Heinvdm/pebble/brain/tests/data/mouths/still/00.jpg

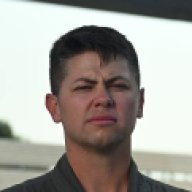
brain/tests/data/mouths/still/00.jpg
