Heinvdm/pebble/brain/tests/data/hazards/woodstove.jpg

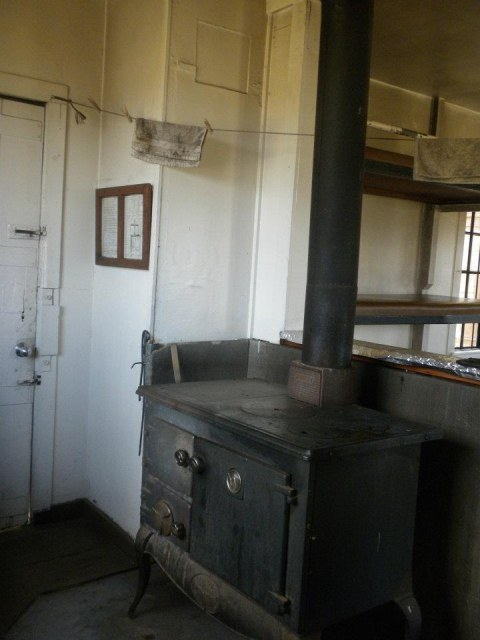
brain/tests/data/hazards/woodstove.jpg
