Heinvdm/pebble/reports/Hexapod motors and boards.md

# Low-resistance motors let Pebble's hexapod hop

Pebble's 12-motor hexapod can reach its hop target, but only with joints about twice the planned weight. The best fit for each lift joint is a **CubeMars GL30 gimbal motor (Ø34.5 × 15.7 mm, 41 g, 1.53 Ω)** turning a **single-stage printed planetary gear of about 8:1**, read by a **14-bit MT6701 magnetic encoder**, with an open **SimpleFOC-microspora-style board (STM32G431 + TI DRV8316, 33 × 34 mm, MIT licence)** bolted behind every motor. At the fixed 9 V the Xiaomi bank gives, a motor's winding resistance, not its size, decides whether it can push 0.35 Nm at 10 rad/s. The GL30 can, losing about 0.35 W per joint while holding the walking load. The cheaper, high-resistance **iPower GBM2804H-100T** reaches only about 0.17 Nm at hop speed, so it is better kept for the six swing joints,
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
