Heinvdm/pebble/android/docs/emulator-face.png

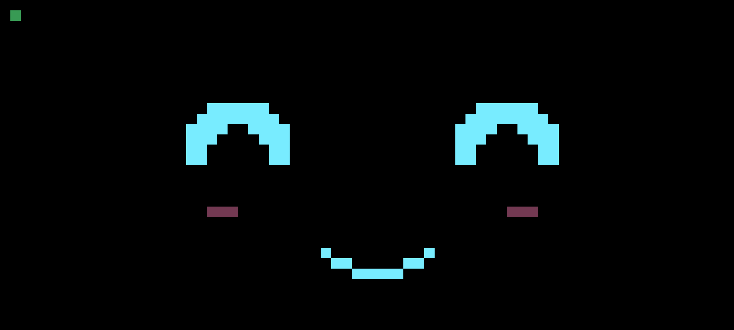
android/docs/emulator-face.png
