Heinvdm/pebble/cad/renders/detail_air_pod.png

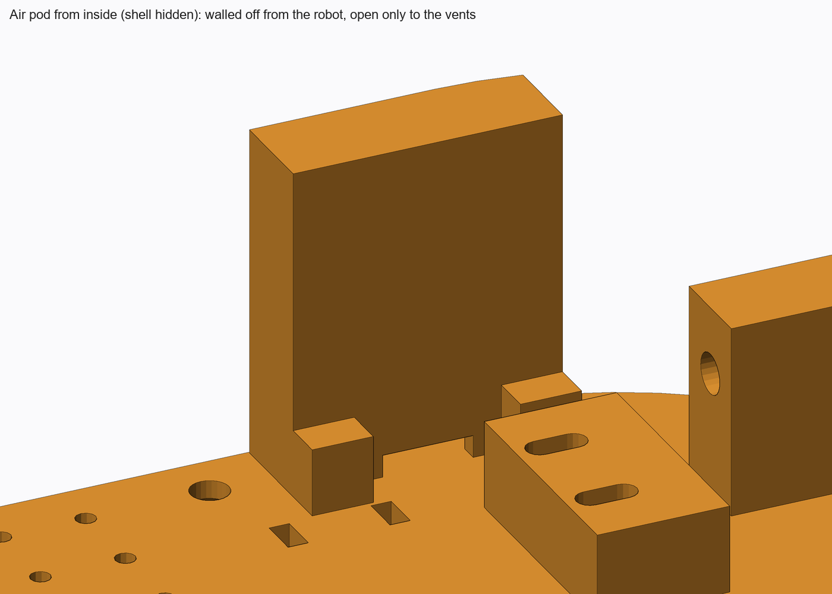
cad/renders/detail_air_pod.png
