Heinvdm/pebble/cad/renders/detail_air_vents.png

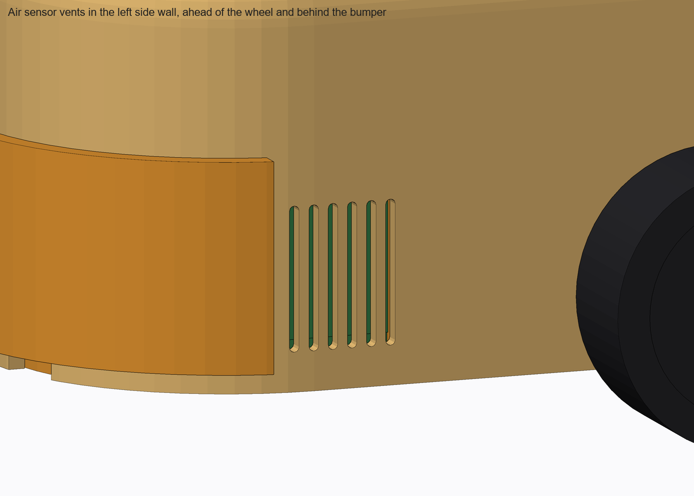
cad/renders/detail_air_vents.png
