Heinvdm/pebble/cad/renders/detail_front_interior.png

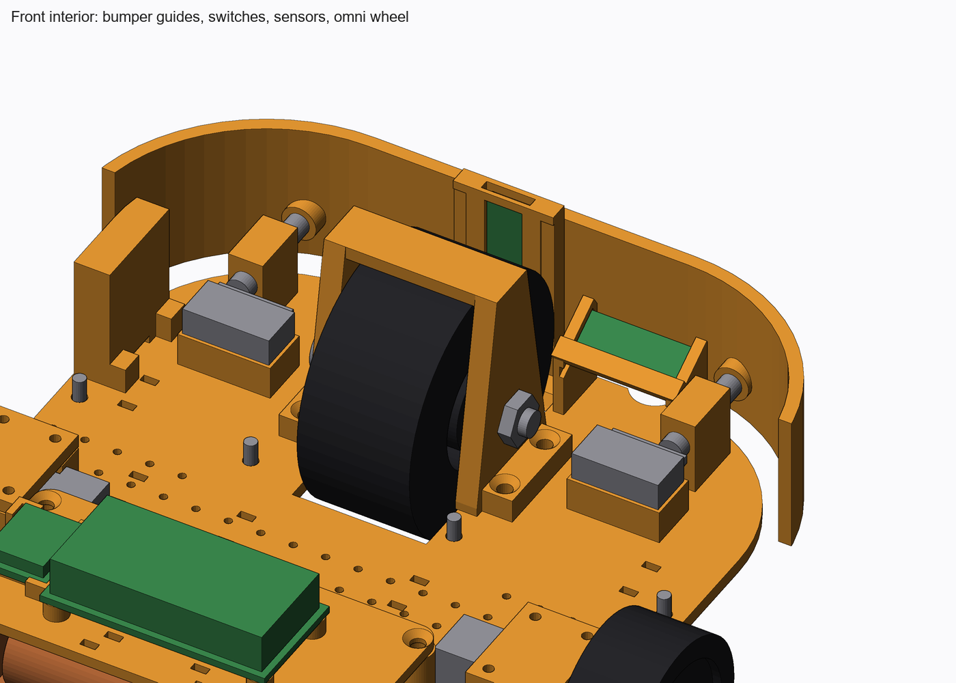
cad/renders/detail_front_interior.png
