Heinvdm/pebble/cad/renders/detail_neck_back.png

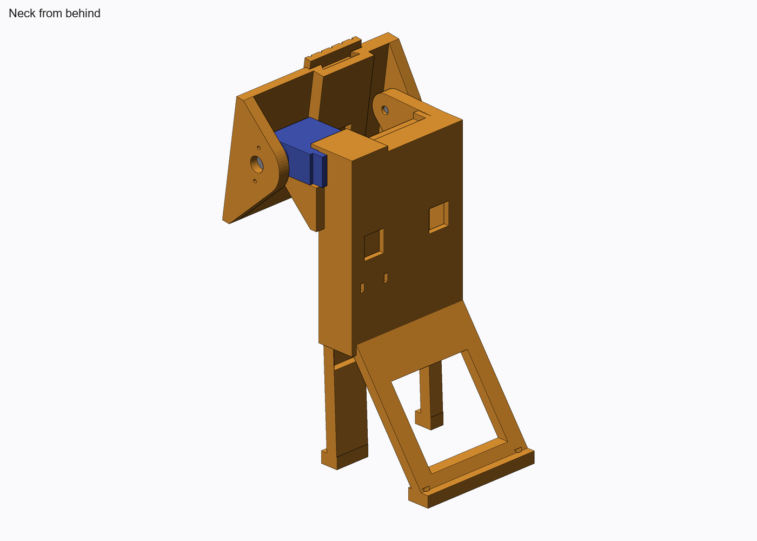
cad/renders/detail_neck_back.png
