Heinvdm/pebble/cad/renders/detail_neck_front.png

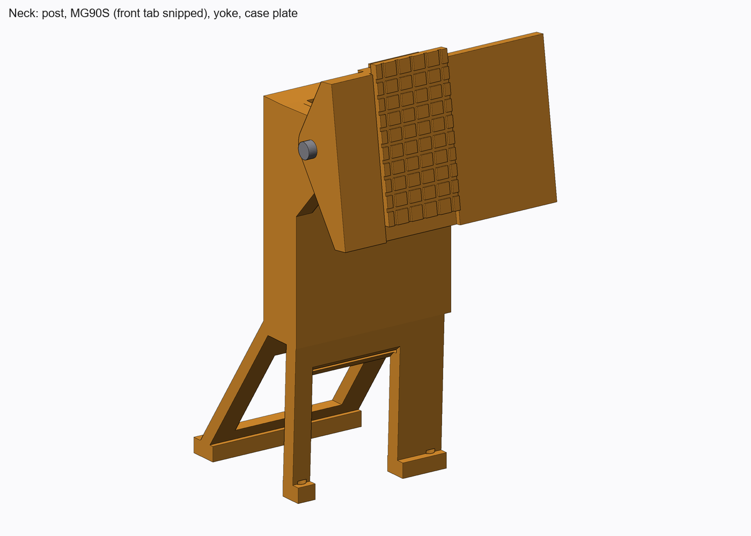
cad/renders/detail_neck_front.png
