Heinvdm/pebble/cad/renders/detail_rear_wall.png

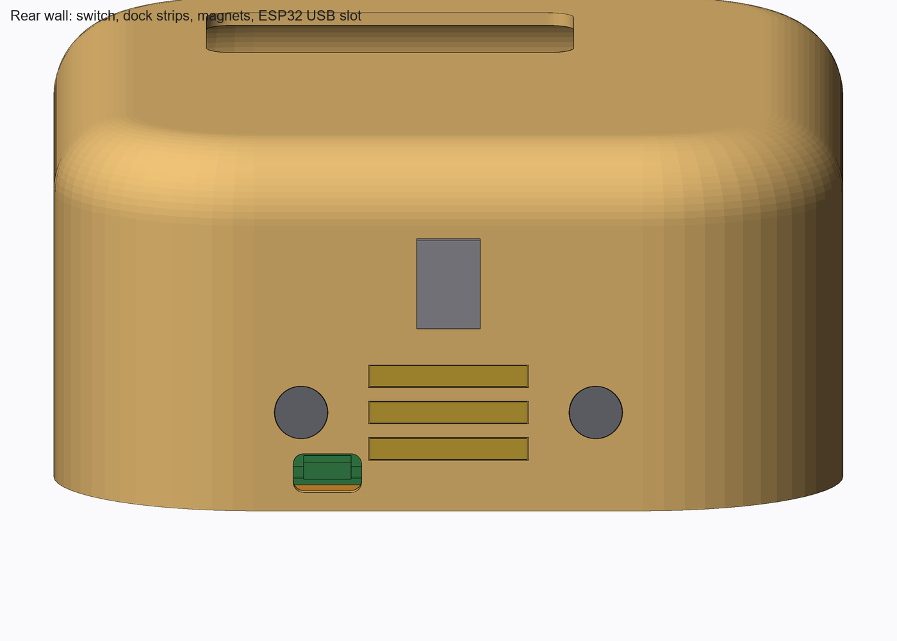
cad/renders/detail_rear_wall.png
