Heinvdm/pebble/cad/renders/detail_underside.png

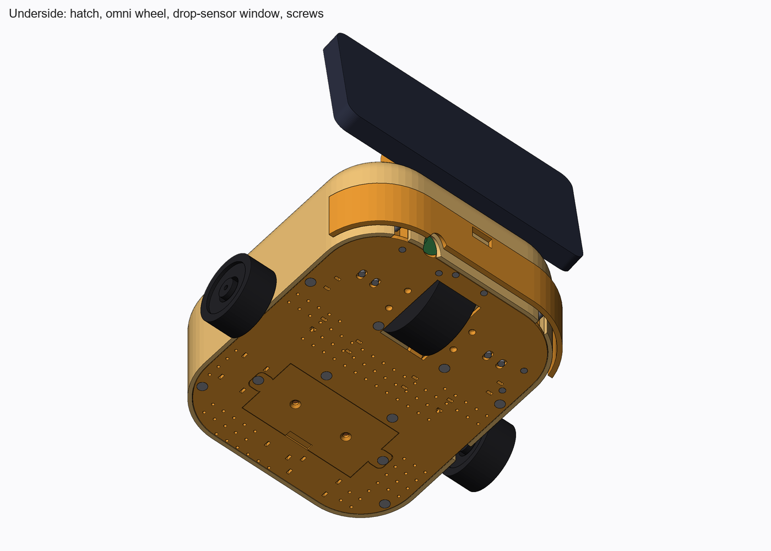
cad/renders/detail_underside.png
