Heinvdm/pebble/cad/renders/dock_iso.png

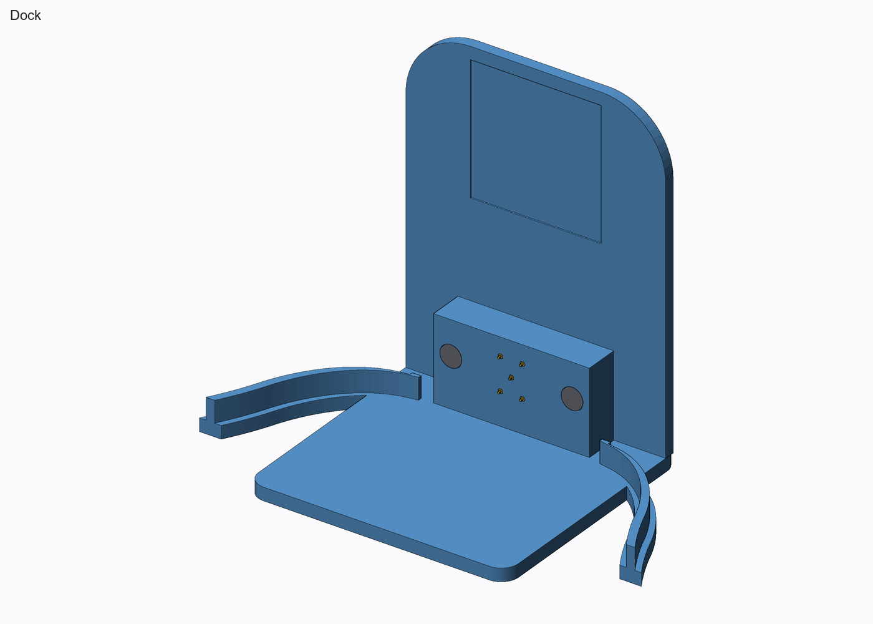
cad/renders/dock_iso.png
