Heinvdm/pebble/cad/renders/docked_rear_iso.png

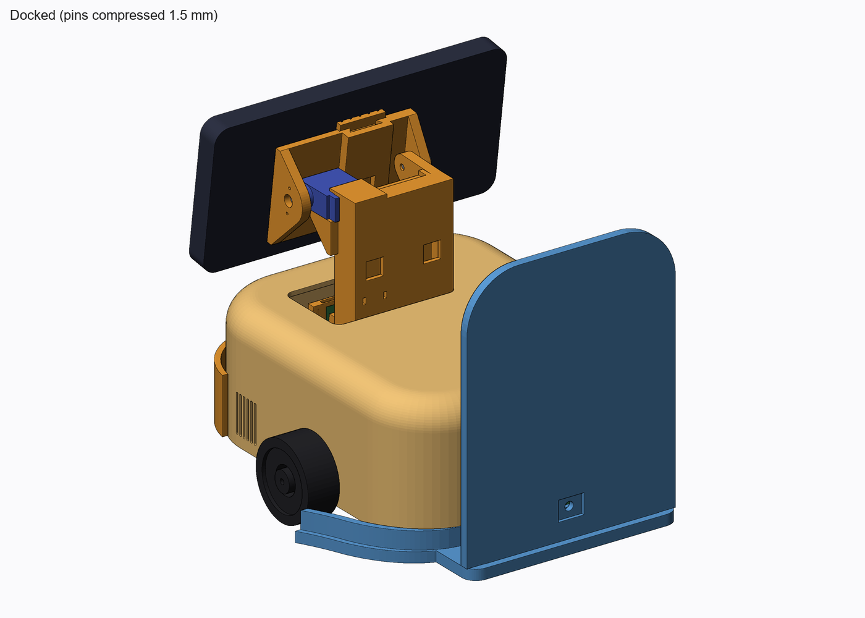
cad/renders/docked_rear_iso.png
