Heinvdm/pebble/cad/renders/docked_side.png

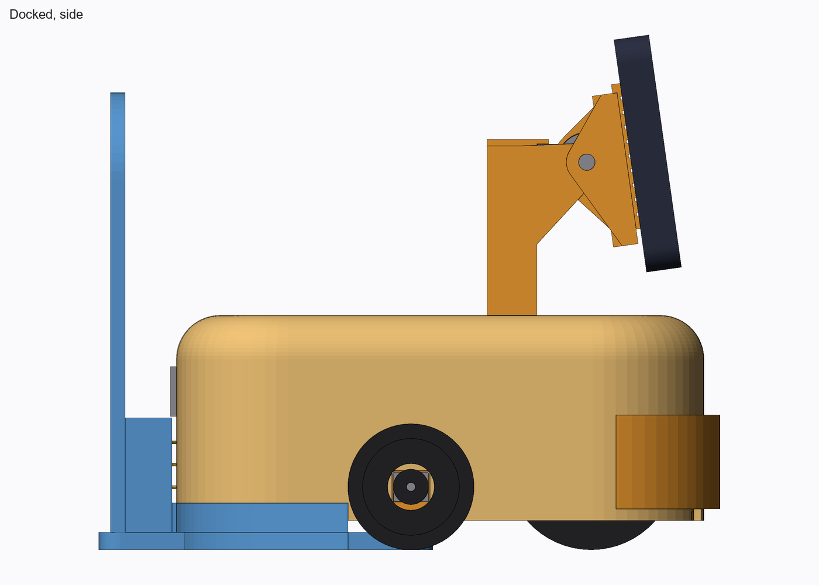
cad/renders/docked_side.png
