Heinvdm/pebble/cad/renders/drop_sensor_front_below.png

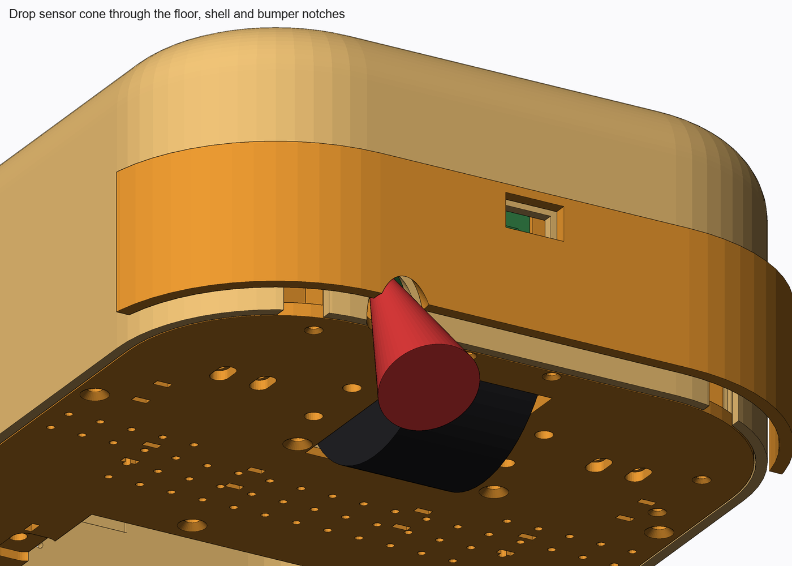
cad/renders/drop_sensor_front_below.png
