Heinvdm/pebble/cad/renders/drop_sensor_side.png

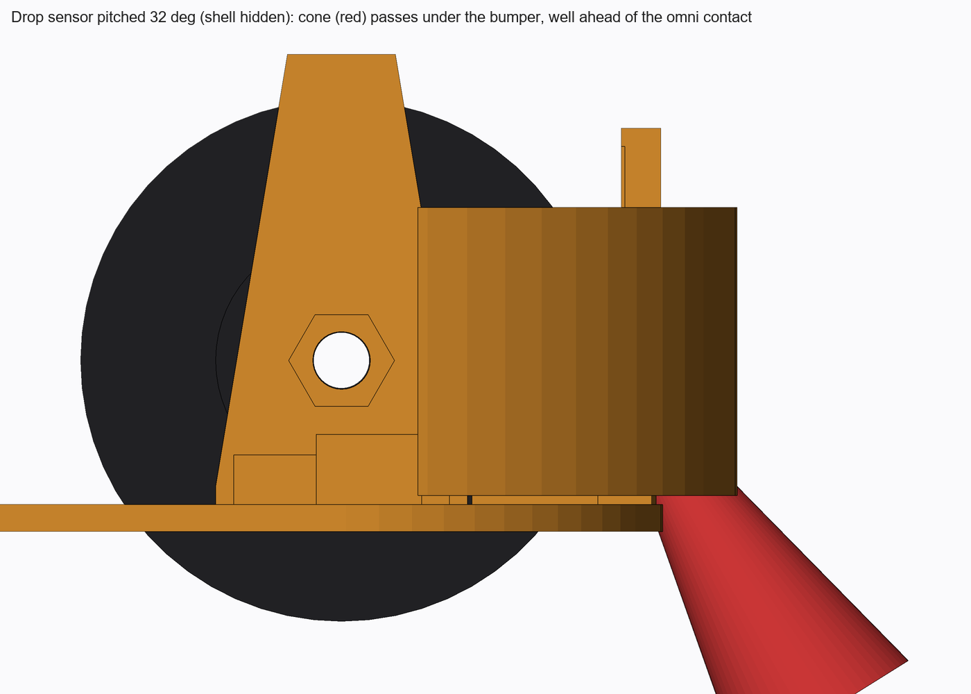
cad/renders/drop_sensor_side.png
