Heinvdm/pebble/cad/renders/layout_iso.png

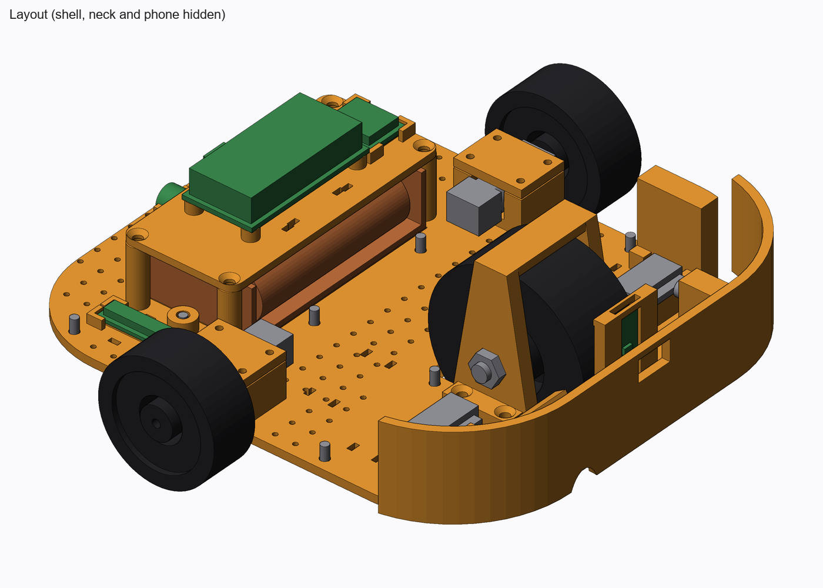
cad/renders/layout_iso.png
