Heinvdm/pebble/cad/renders/layout_top.png

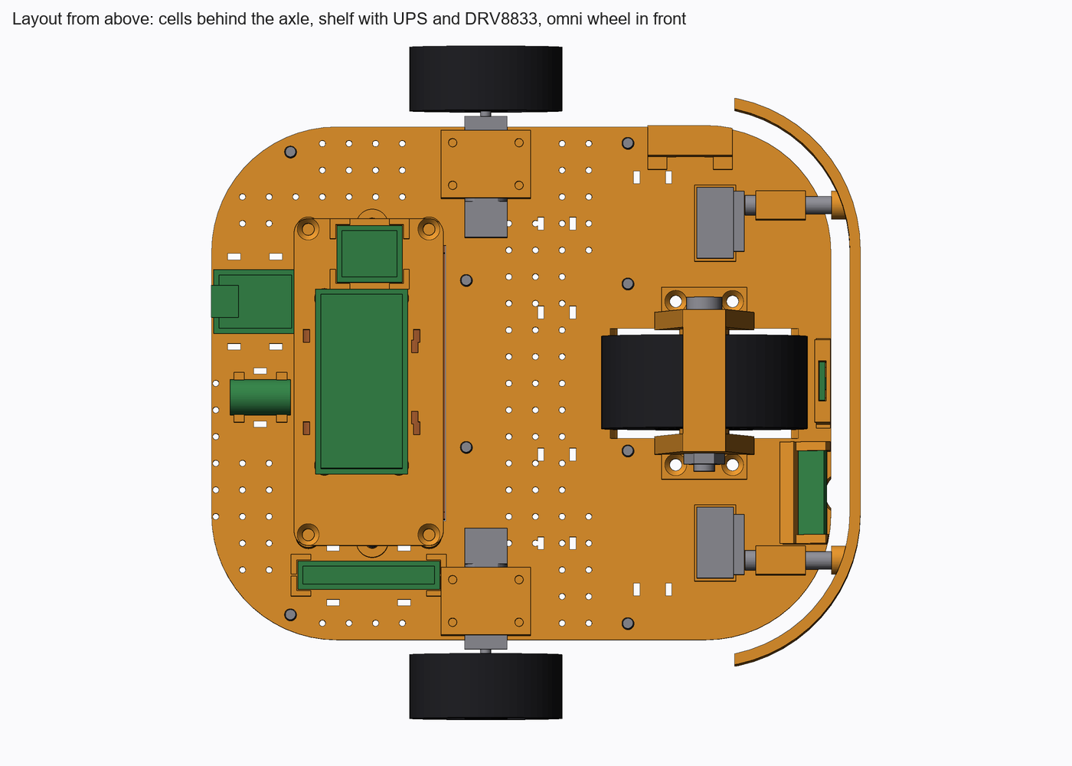
cad/renders/layout_top.png
