Heinvdm/pebble/cad/renders/omni_from_below.png

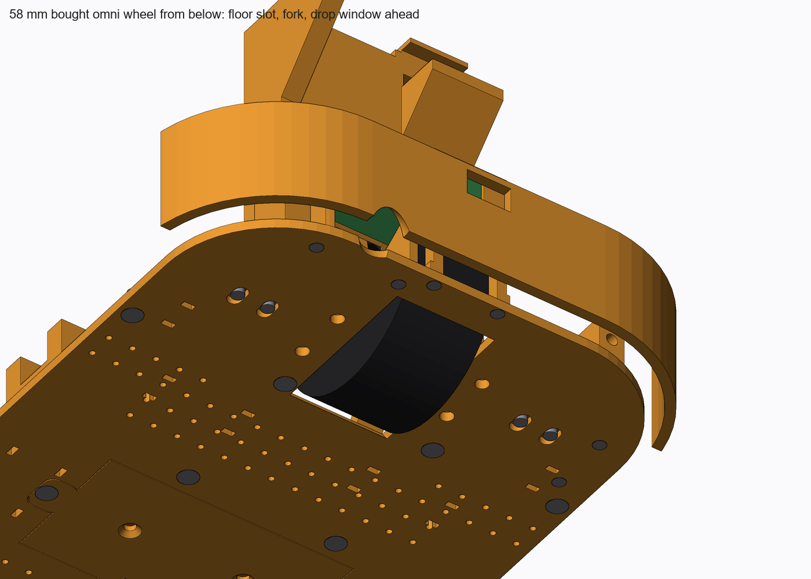
cad/renders/omni_from_below.png
