Heinvdm/pebble/cad/renders/omni_side.png

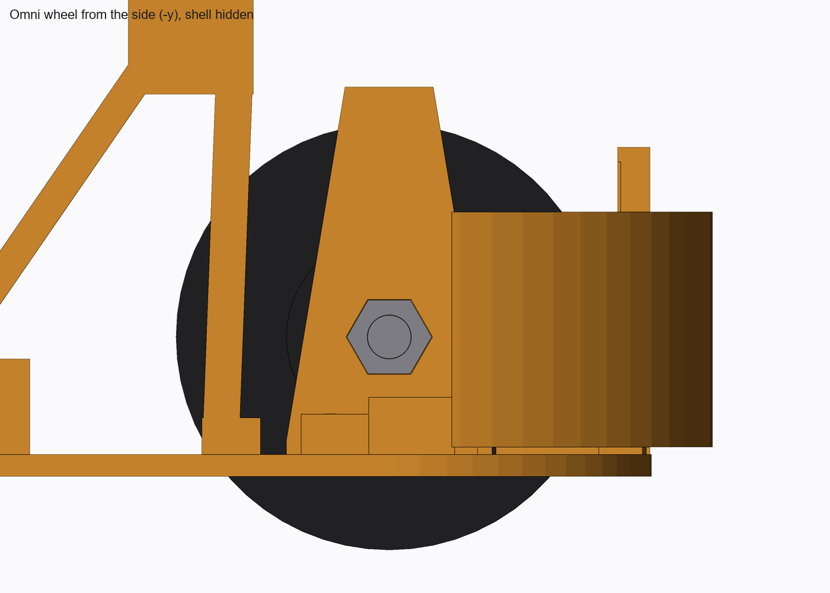
cad/renders/omni_side.png
