Heinvdm/pebble/cad/renders/part_air_pod.png

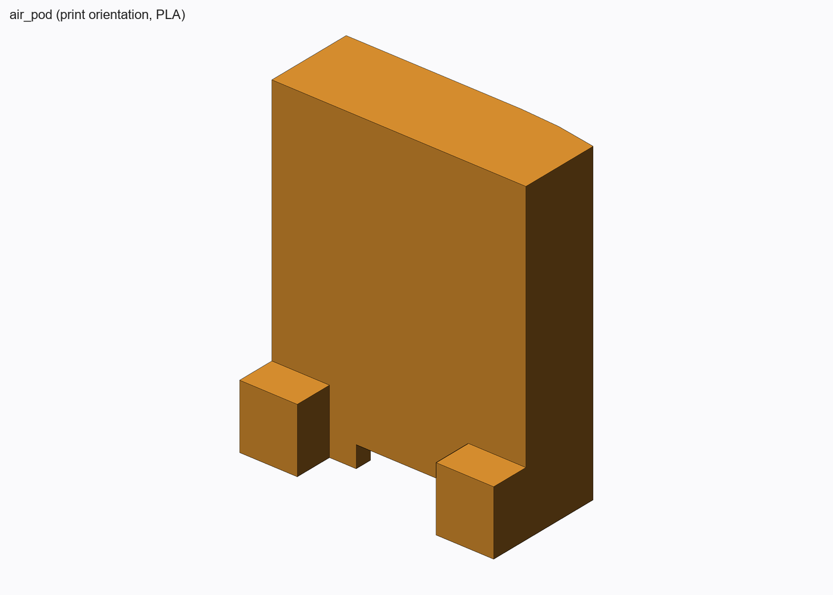
cad/renders/part_air_pod.png
