Heinvdm/pebble/cad/renders/part_battery_hatch.png

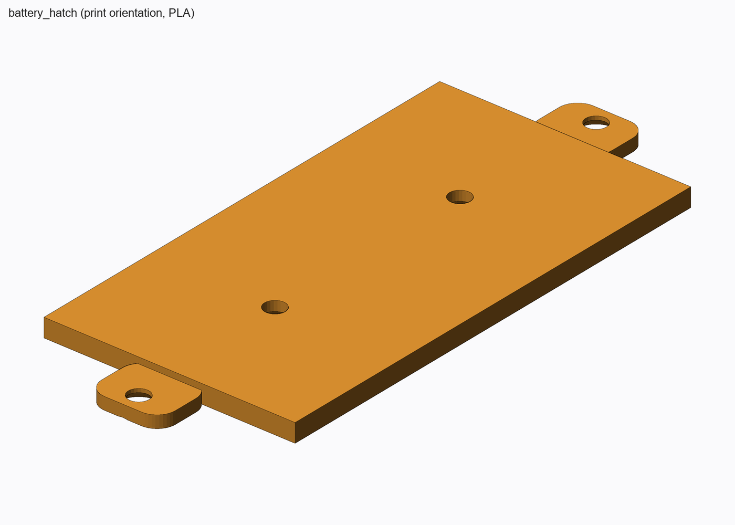
cad/renders/part_battery_hatch.png
