Heinvdm/pebble/cad/renders/part_bumper.png

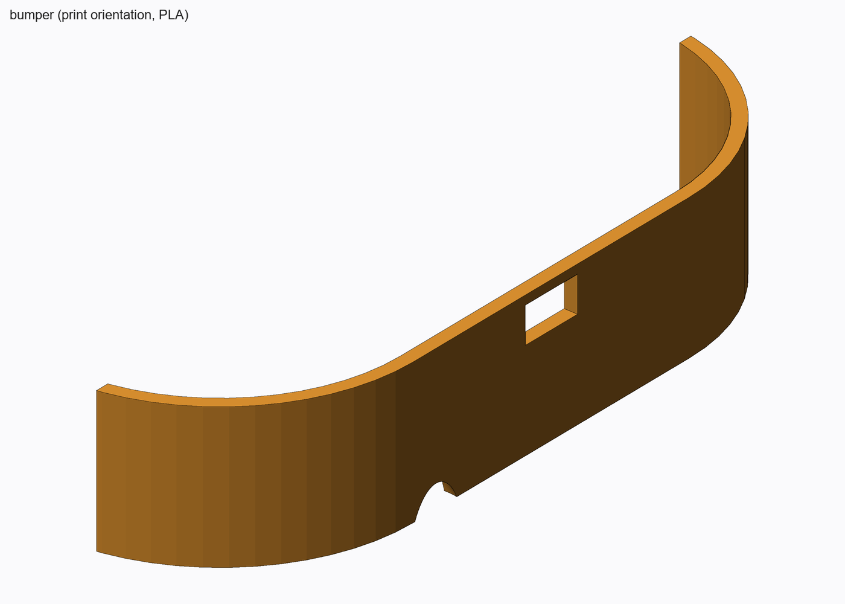
cad/renders/part_bumper.png
