Heinvdm/pebble/cad/renders/part_case_plate.png

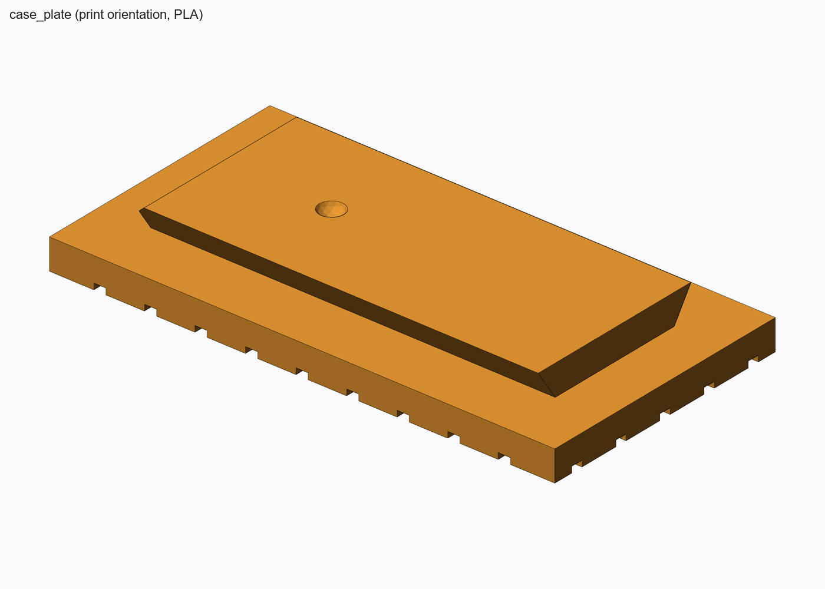
cad/renders/part_case_plate.png
