Heinvdm/pebble/cad/renders/part_chassis_floor.png

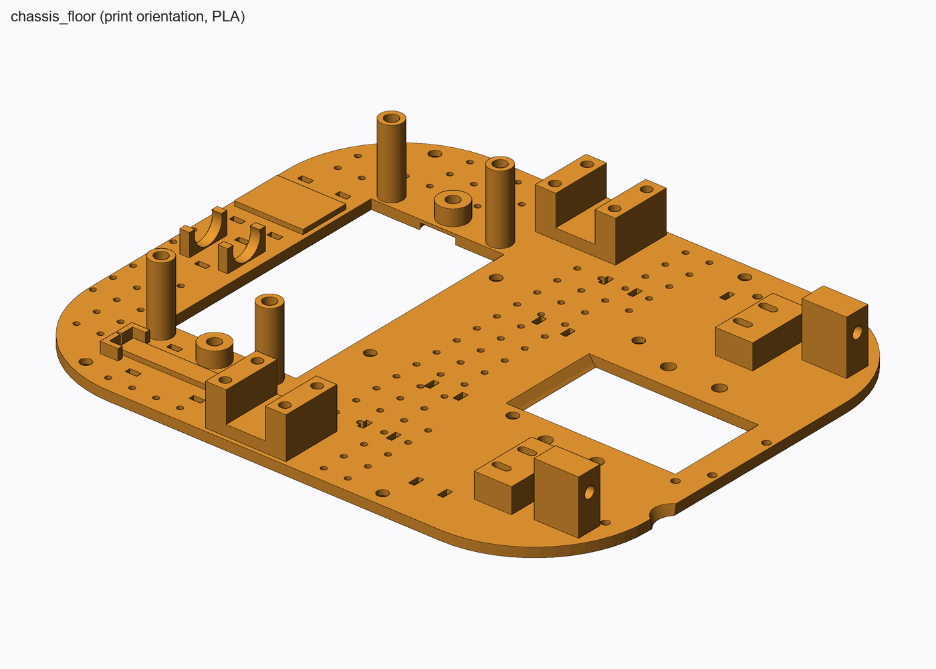
cad/renders/part_chassis_floor.png
