Heinvdm/pebble/cad/renders/part_dock_base.png

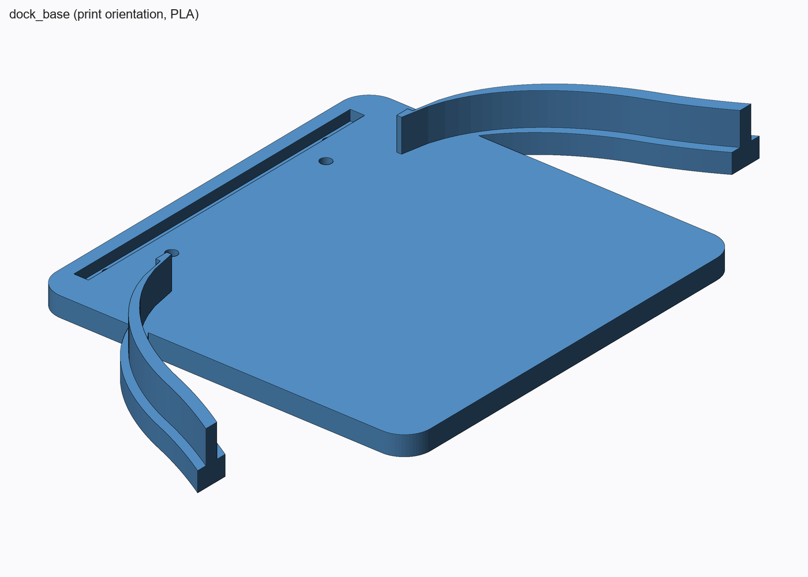
cad/renders/part_dock_base.png
