Heinvdm/pebble/cad/renders/part_dock_pin_block.png

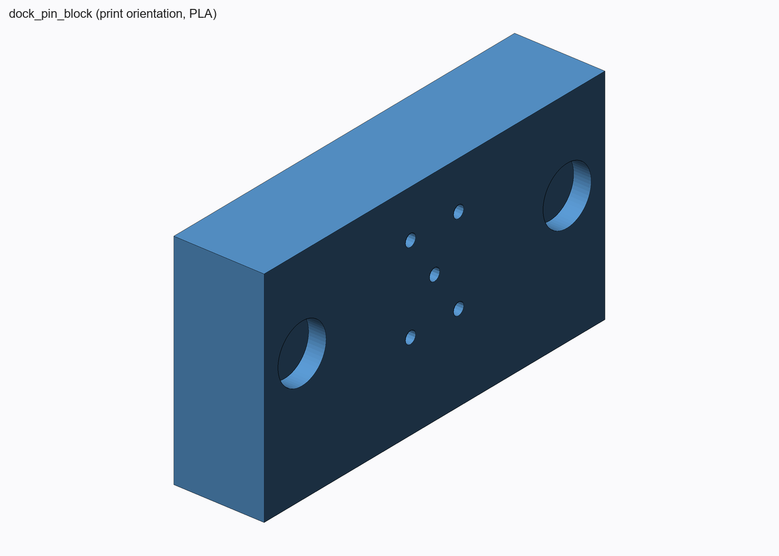
cad/renders/part_dock_pin_block.png
