Heinvdm/pebble/cad/renders/part_dock_wall.png

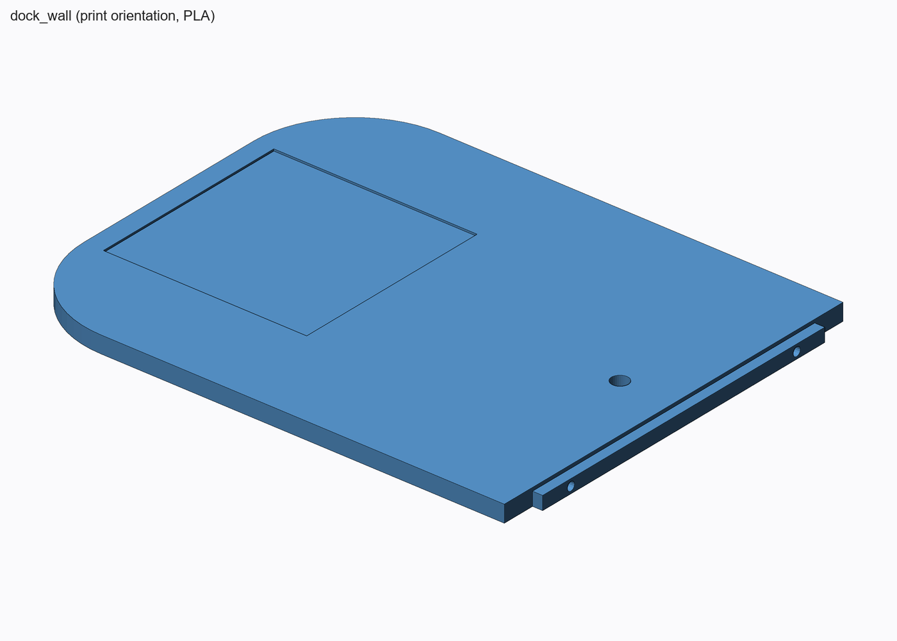
cad/renders/part_dock_wall.png
