Heinvdm/pebble/cad/renders/part_drop_sensor_bracket.png

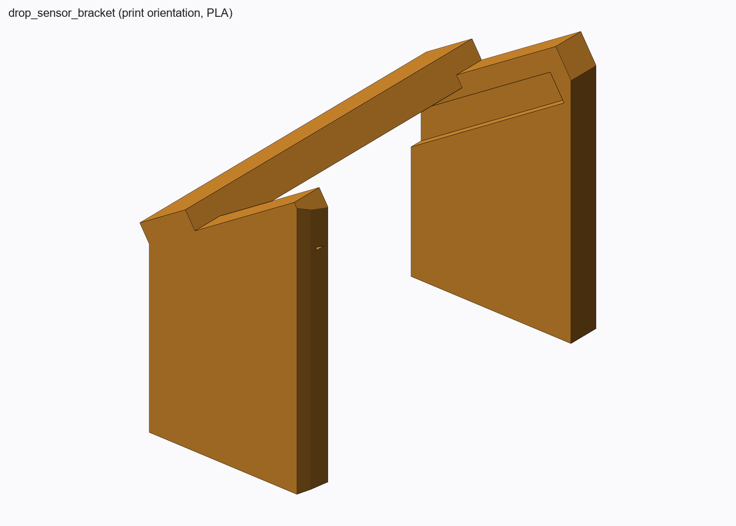
cad/renders/part_drop_sensor_bracket.png
