Heinvdm/pebble/cad/renders/part_electronics_shelf.png

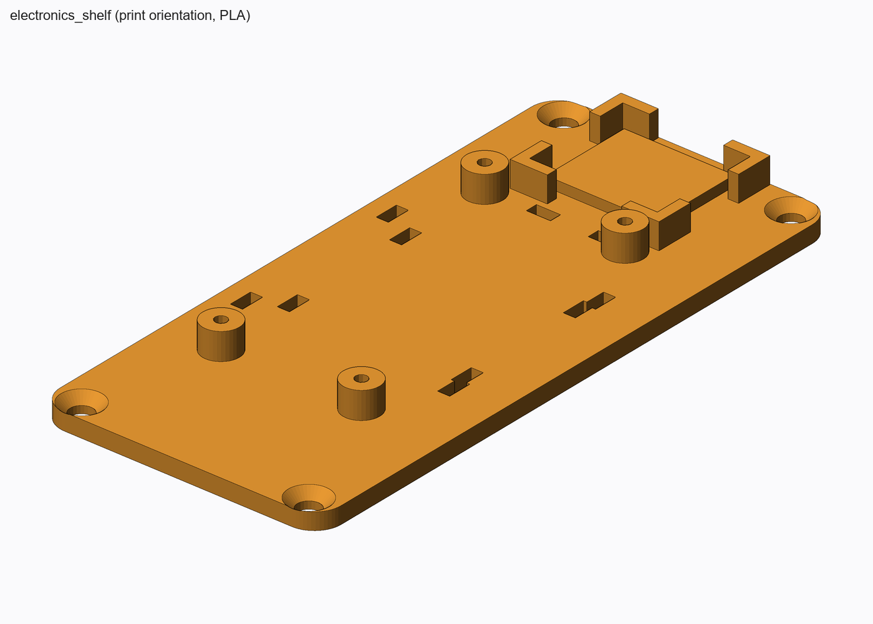
cad/renders/part_electronics_shelf.png
