Heinvdm/pebble/cad/renders/part_front_sensor_mount.png

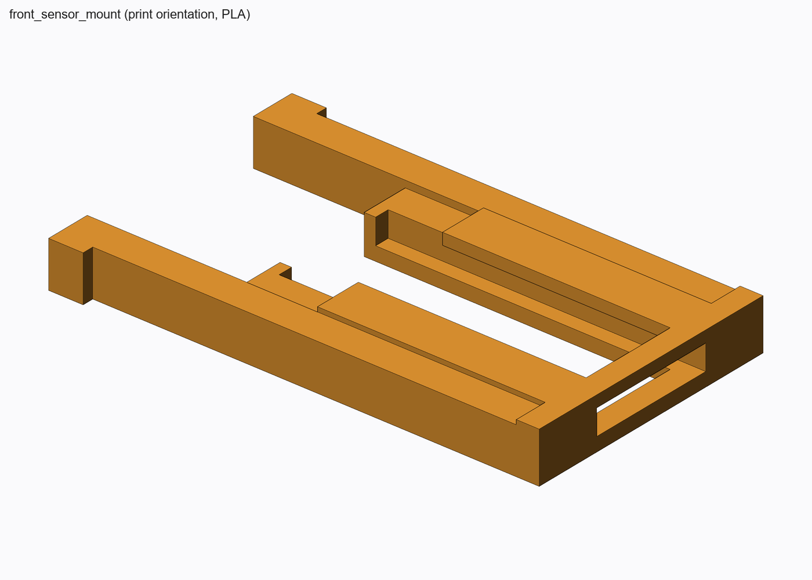
cad/renders/part_front_sensor_mount.png
