Heinvdm/pebble/cad/renders/part_motor_clamp_cap.png

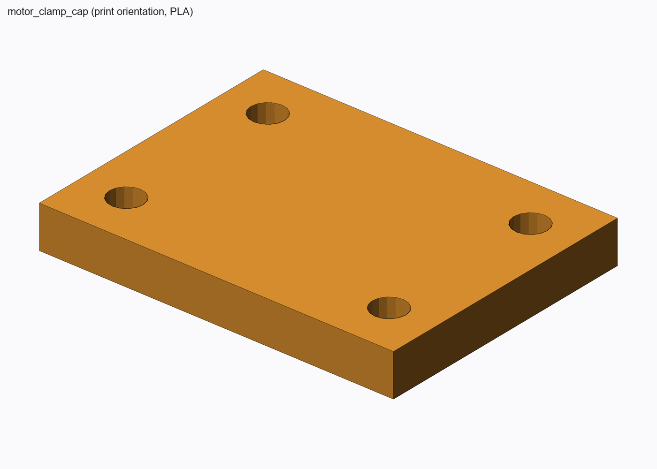
cad/renders/part_motor_clamp_cap.png
