Heinvdm/pebble/cad/renders/part_neck_post.png

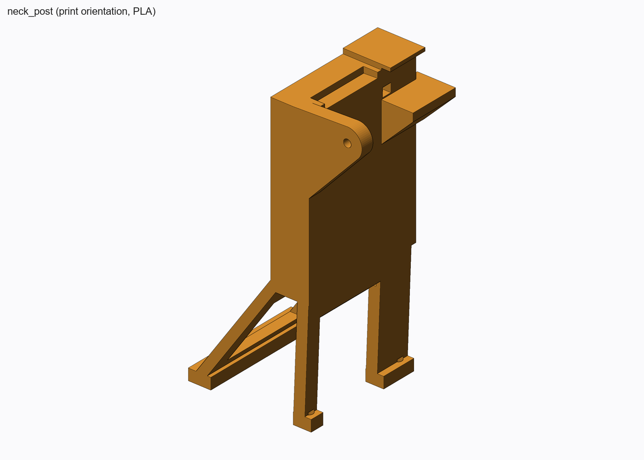
cad/renders/part_neck_post.png
