Heinvdm/pebble/cad/renders/part_omni_fork.png

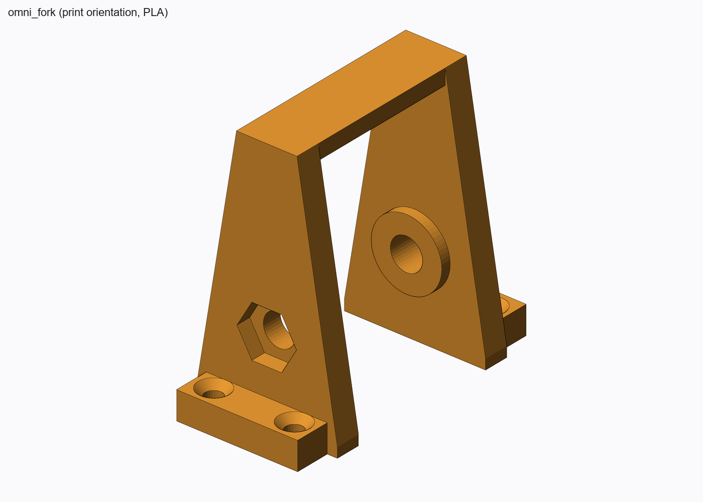
cad/renders/part_omni_fork.png
