Heinvdm/pebble/cad/renders/part_shell.png

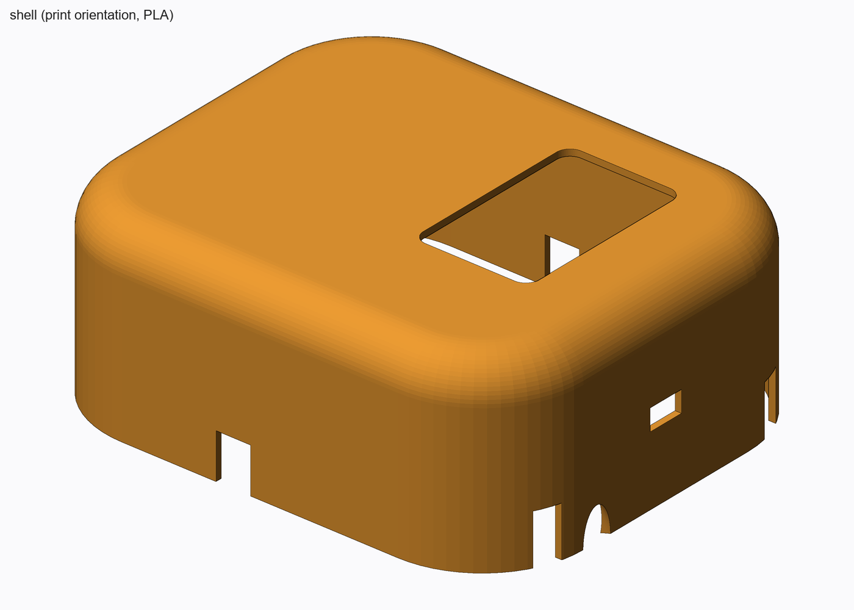
cad/renders/part_shell.png
