Heinvdm/pebble/cad/renders/part_tilt_yoke.png

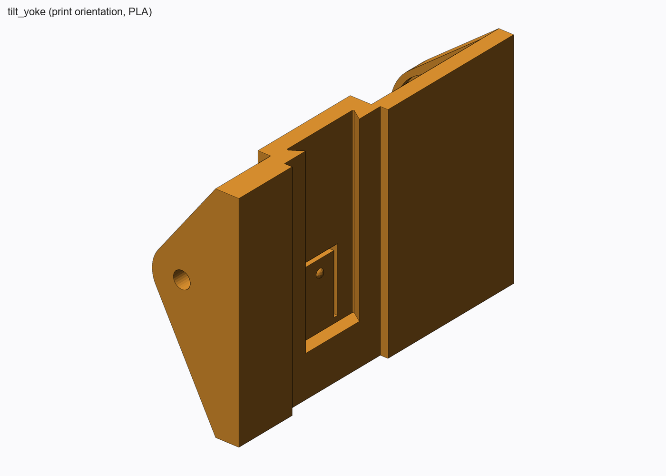
cad/renders/part_tilt_yoke.png
