Heinvdm/pebble/cad/renders/part_wheel_hub.png

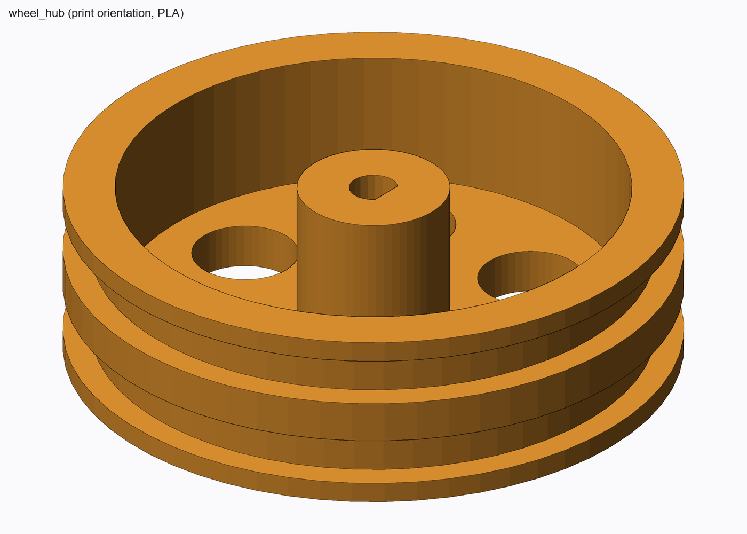
cad/renders/part_wheel_hub.png
