Heinvdm/pebble/cad/stl/motor_clamp_cap.stl

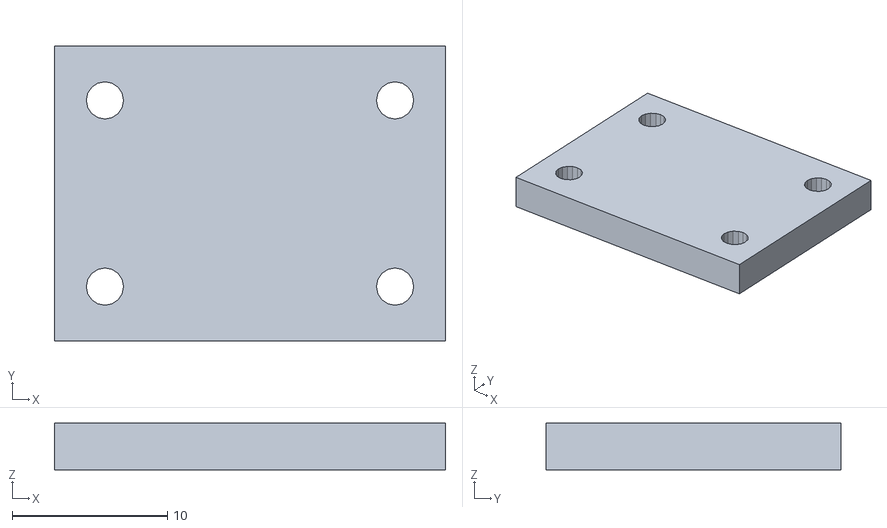
[picture p37: CAD file, 2026-10-23]
cad/stl/motor_clamp_cap.stl
25.2 x 19.0 x 3.00
