Heinvdm/pebble/cad/stl/omni_fork.stl

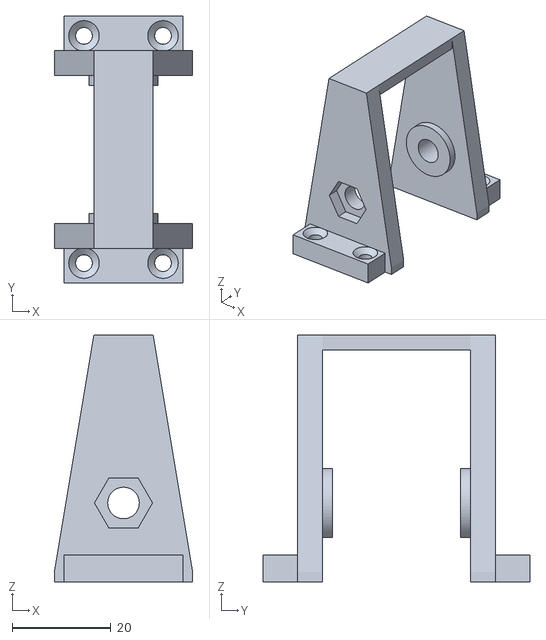
[picture p38: CAD file, 2026-10-23]
cad/stl/omni_fork.stl
28.0 x 54.0 x 50.0
