Heinvdm/pebble/cad/stl/air_pod.stl

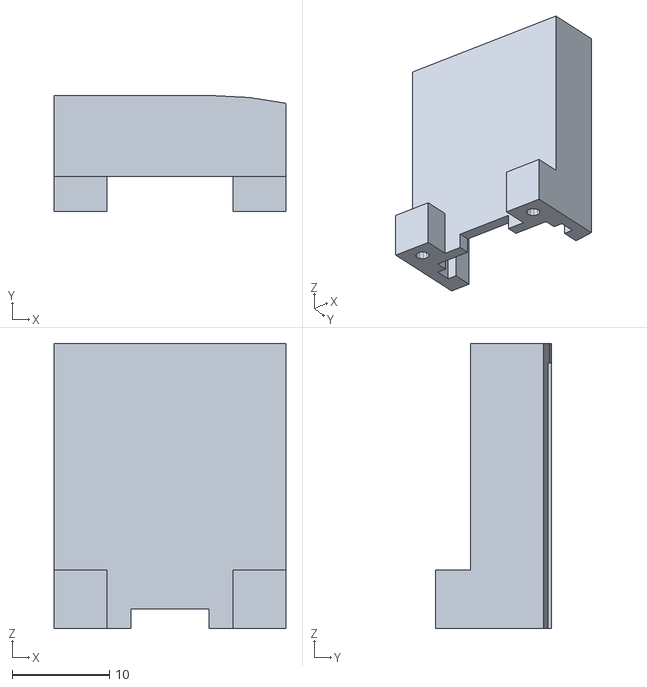
[picture p39: CAD file, 2026-10-23]
cad/stl/air_pod.stl
23.8 x 11.9 x 29.3
