Heinvdm/pebble/cad/stl/battery_hatch.stl

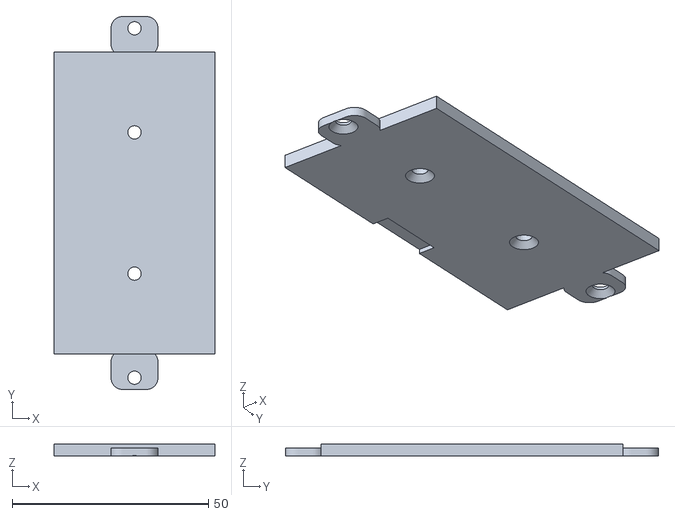
[picture p40: CAD file, 2026-10-23]
cad/stl/battery_hatch.stl
41.0 x 95.0 x 3.00
