Heinvdm/pebble/cad/stl/dock_base.stl

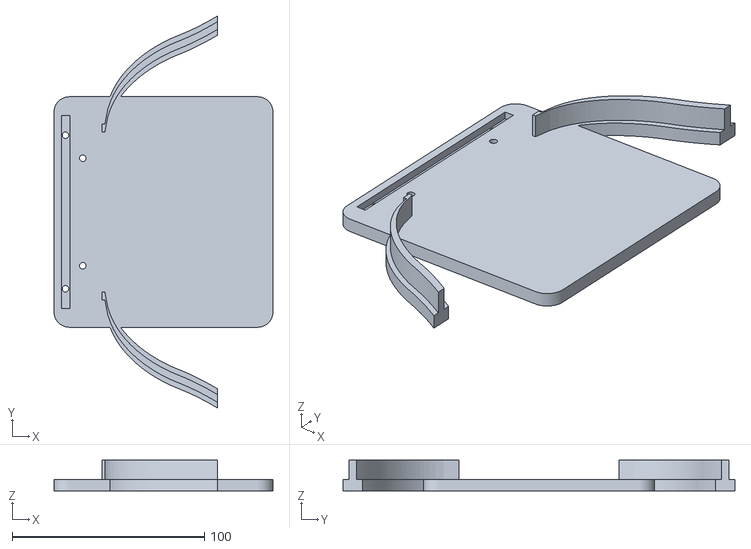
[picture p41: CAD file, 2026-10-23]
cad/stl/dock_base.stl
114.0 x 204.0 x 16.0
