Heinvdm/pebble/cad/stl/bumper.stl

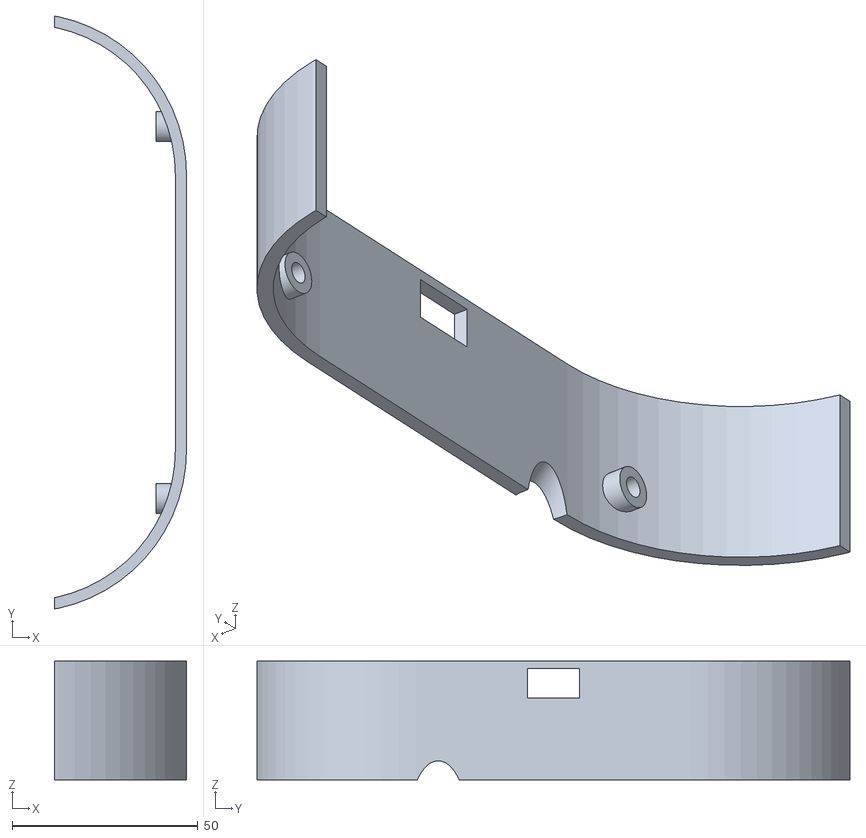
[picture p42: CAD file, 2026-10-23]
cad/stl/bumper.stl
35.5 x 159.4 x 32.0
