Heinvdm/pebble/cad/stl/dock_wall.stl

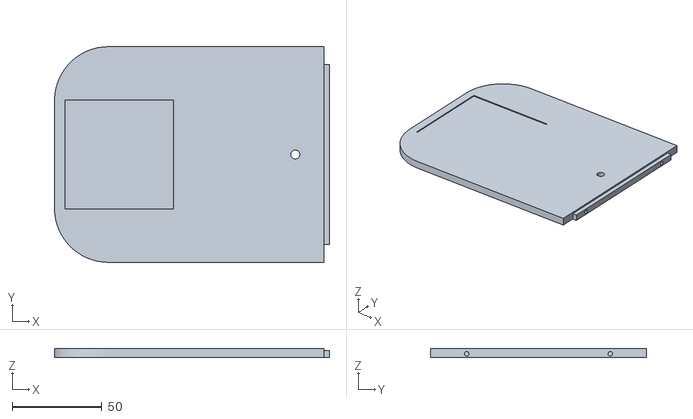
[picture p43: CAD file, 2026-10-23]
cad/stl/dock_wall.stl
153.0 x 120.0 x 5.00
