Heinvdm/pebble/cad/stl/case_plate.stl

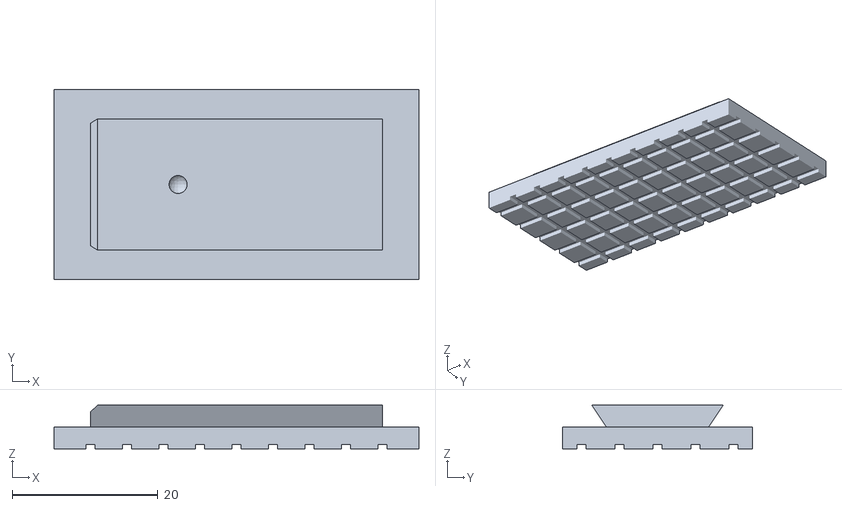
[picture p44: CAD file, 2026-10-23]
cad/stl/case_plate.stl
50.0 x 26.0 x 6.00
