Heinvdm/pebble/cad/stl/shell.stl

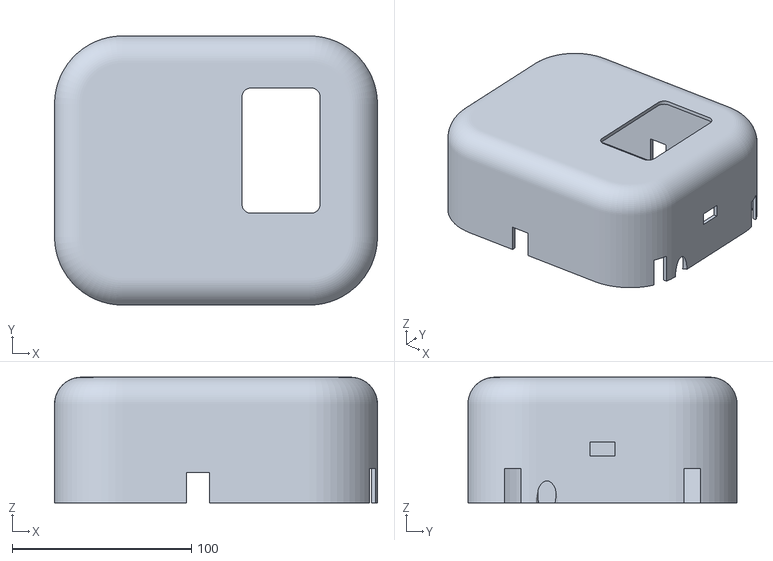
[picture p45: CAD file, 2026-10-23]
cad/stl/shell.stl
180.0 x 150.0 x 70.0
