Heinvdm/pebble/cad/stl/front_sensor_mount.stl

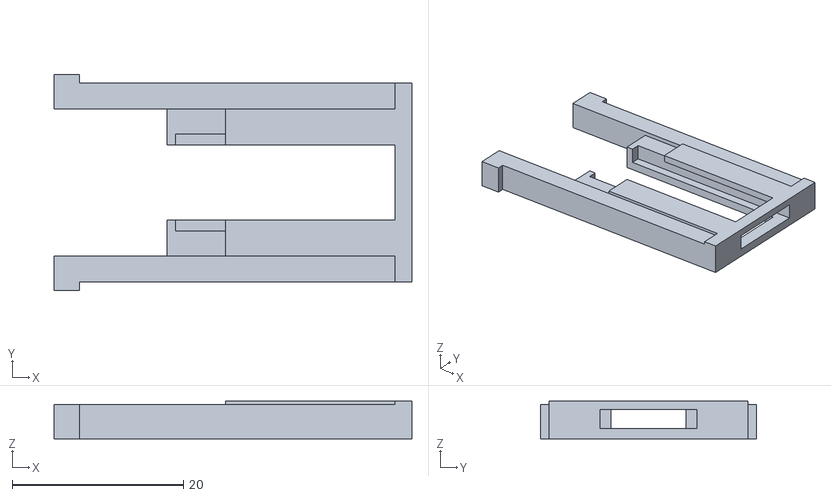
[picture p46: CAD file, 2026-10-23]
cad/stl/front_sensor_mount.stl
41.8 x 25.2 x 4.40
