Heinvdm/pebble/cad/stl/dock_pin_block.stl

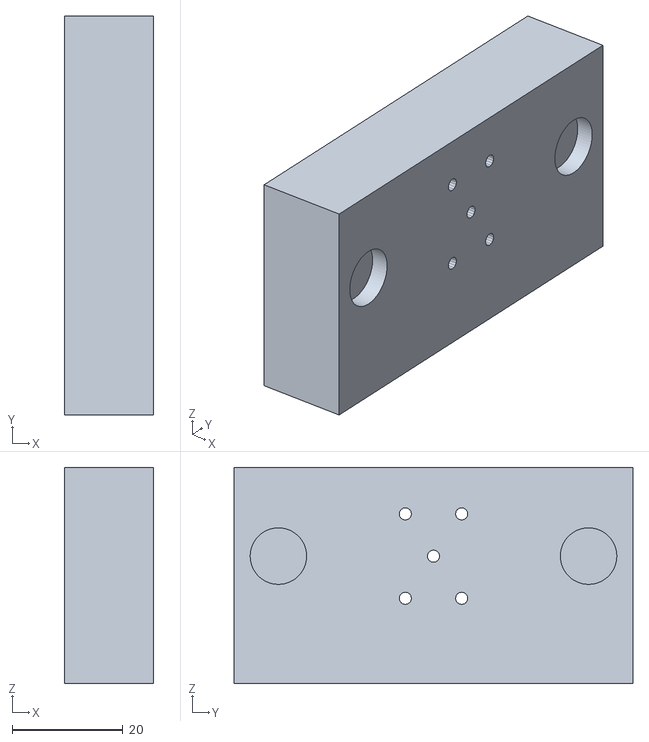
[picture p47: CAD file, 2026-10-23]
cad/stl/dock_pin_block.stl
16.0 x 72.0 x 39.0
