Heinvdm/pebble/cad/stl/chassis_floor.stl

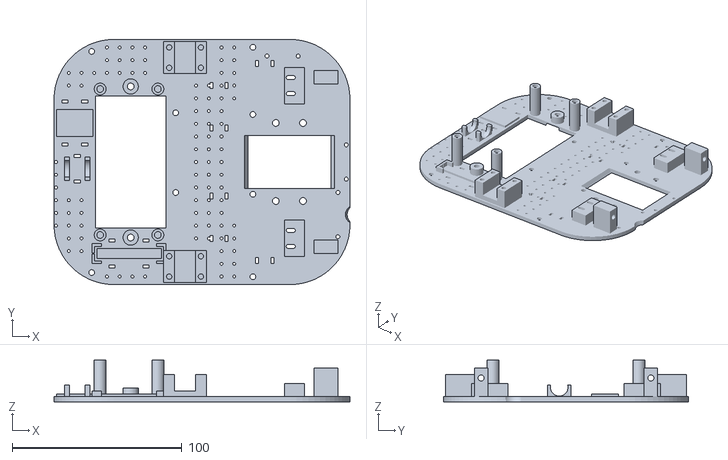
[picture p48: CAD file, 2026-10-23]
cad/stl/chassis_floor.stl
174.4 x 144.4 x 24.5
