Heinvdm/pebble/cad/stl/drop_sensor_bracket.stl

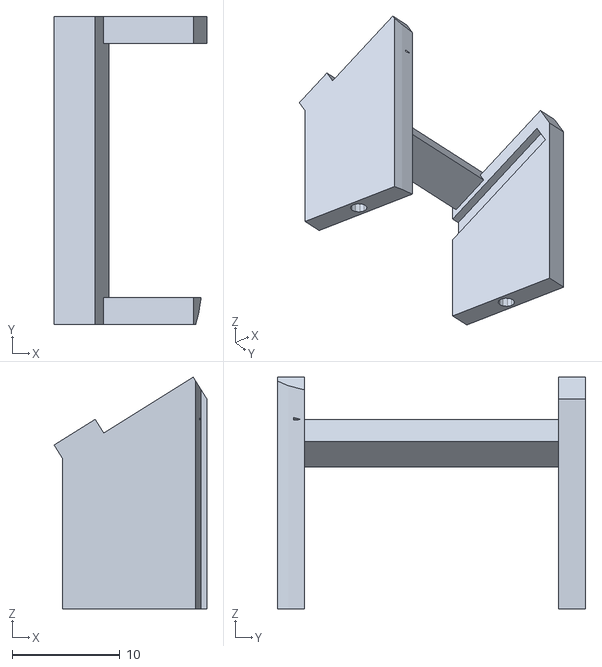
[picture p49: CAD file, 2026-10-23]
cad/stl/drop_sensor_bracket.stl
14.2 x 28.6 x 21.5
