Heinvdm/pebble/cad/stl/tilt_yoke.stl

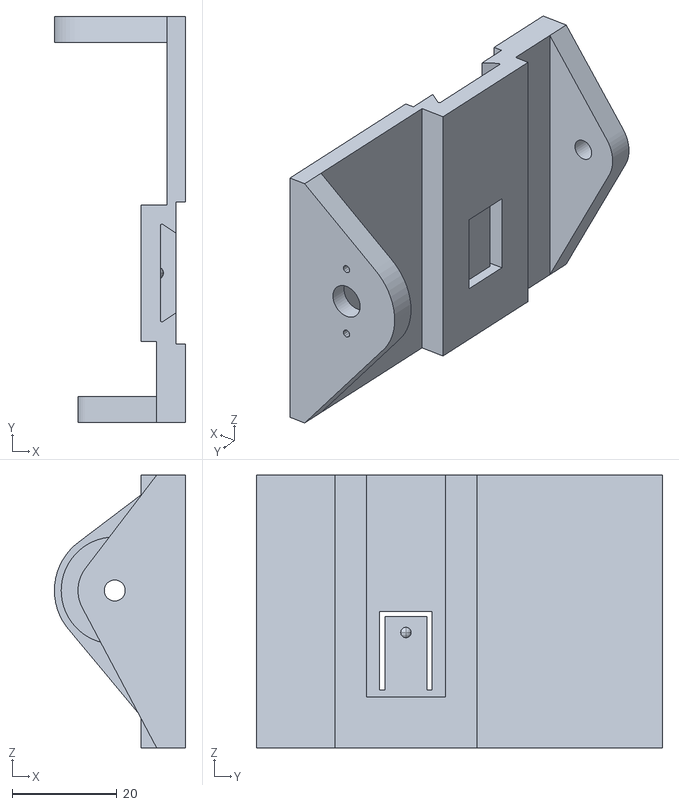
[picture p50: CAD file, 2026-10-23]
cad/stl/tilt_yoke.stl
25.0 x 77.4 x 52.0
