Heinvdm/pebble/cad/stl/wheel_hub.stl

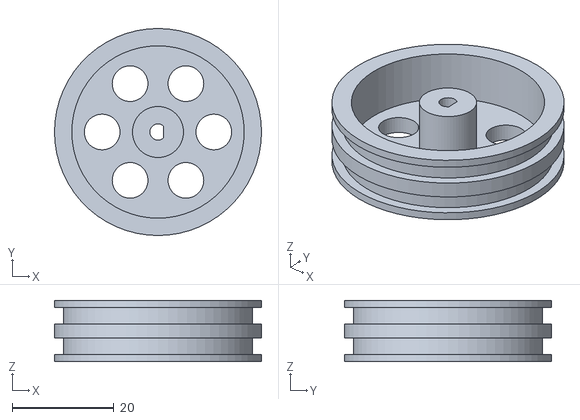
[picture p51: CAD file, 2026-10-23]
cad/stl/wheel_hub.stl
40.6 x 40.6 x 12.0
