Heinvdm/pebble/cad/stl/neck_post.stl

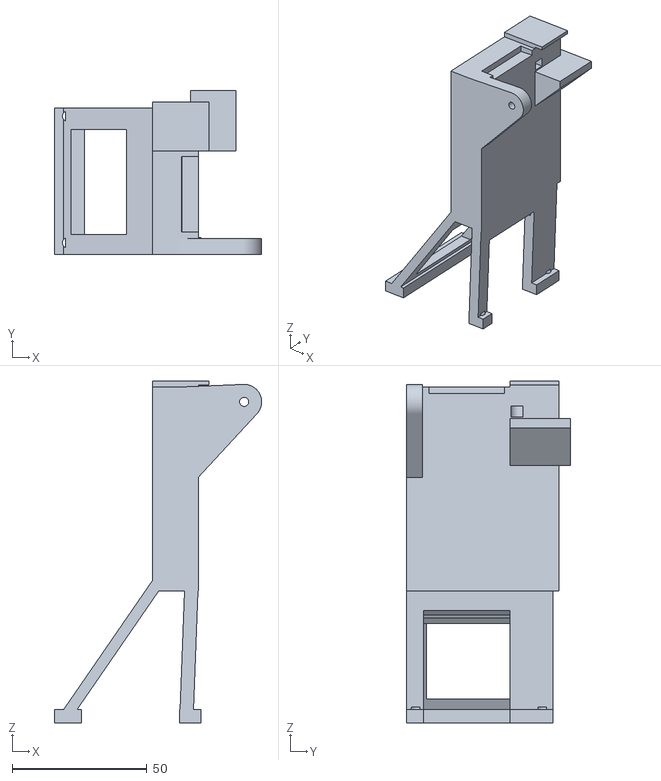
[picture p52: CAD file, 2026-10-23]
cad/stl/neck_post.stl
77.0 x 60.8 x 127.0
