Heinvdm/pebble/cad/stl/electronics_shelf.stl

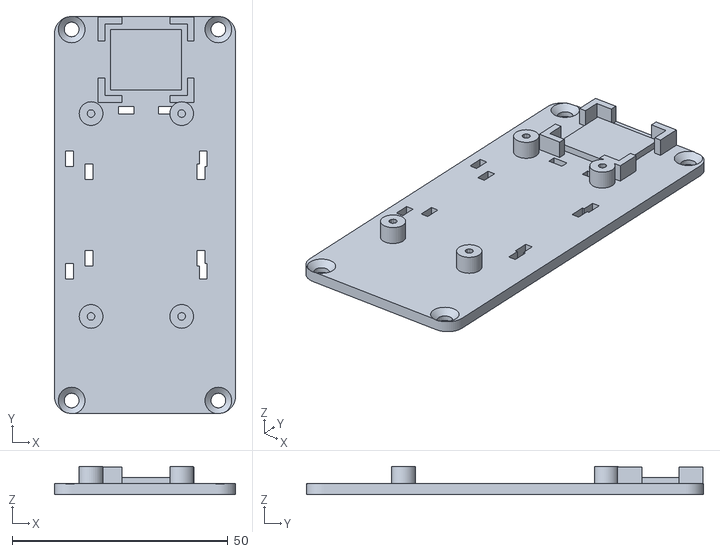
[picture p53: CAD file, 2026-10-23]
cad/stl/electronics_shelf.stl
42.0 x 92.0 x 6.50
