Heinvdm/pebble/cad/renders/assembly_front_iso_down35.png

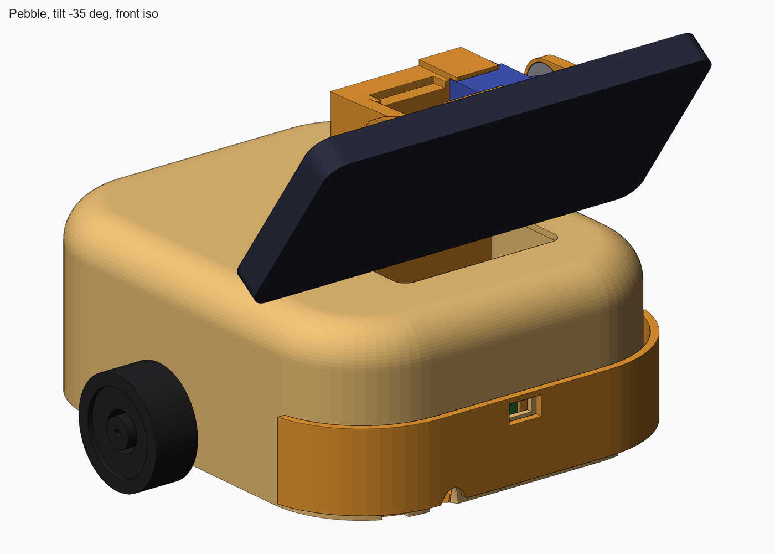
cad/renders/assembly_front_iso_down35.png
