Heinvdm/pebble/cad/renders/assembly_front_iso_rest.png

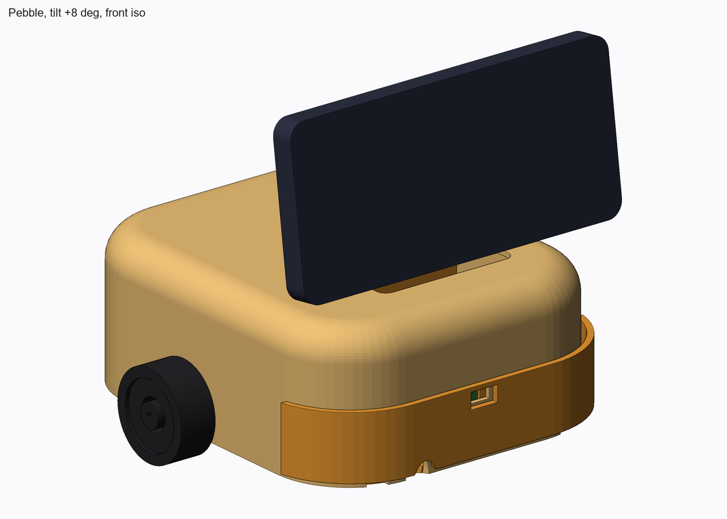
cad/renders/assembly_front_iso_rest.png
