Heinvdm/pebble/cad/renders/assembly_front_iso_up90.png

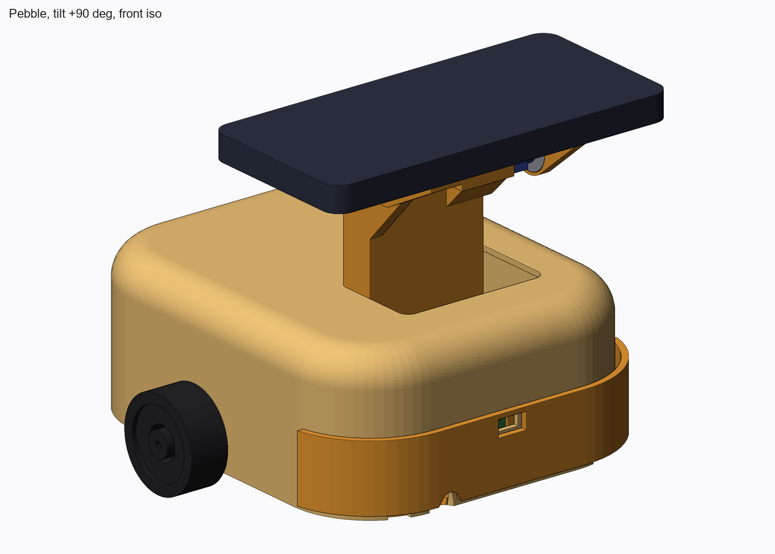
cad/renders/assembly_front_iso_up90.png
