Heinvdm/pebble/cad/renders/assembly_no_shell_iso.png

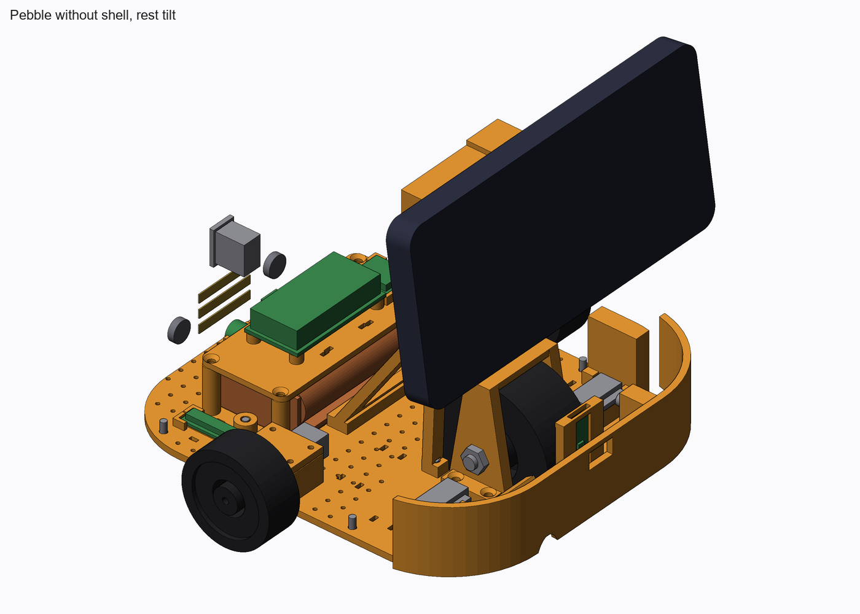
cad/renders/assembly_no_shell_iso.png
