Heinvdm/pebble/cad/renders/assembly_no_shell_rear_iso.png

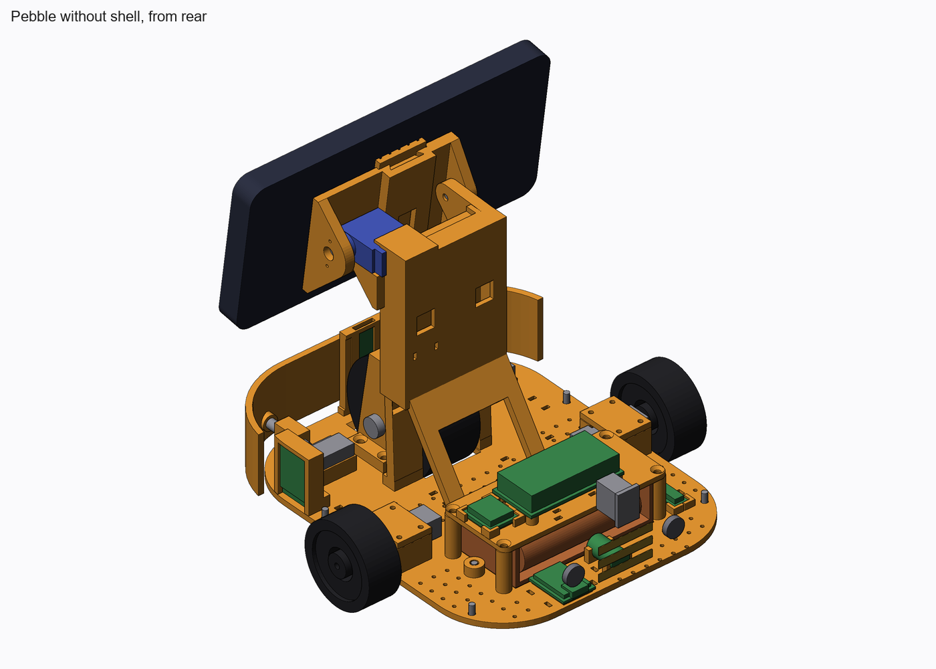
cad/renders/assembly_no_shell_rear_iso.png
