Heinvdm/pebble/cad/renders/assembly_side_down35.png

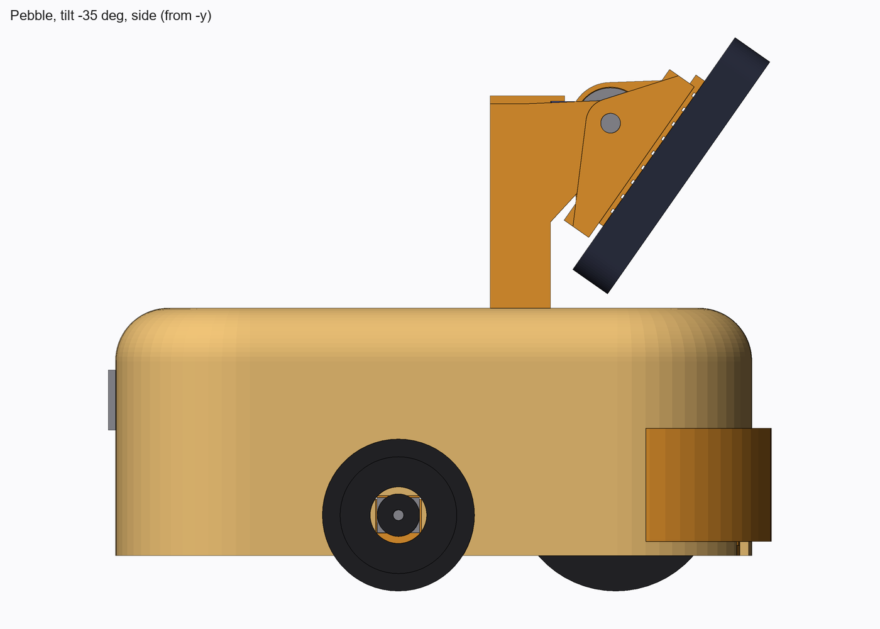
cad/renders/assembly_side_down35.png
