Heinvdm/pebble/cad/renders/assembly_side_rest.png

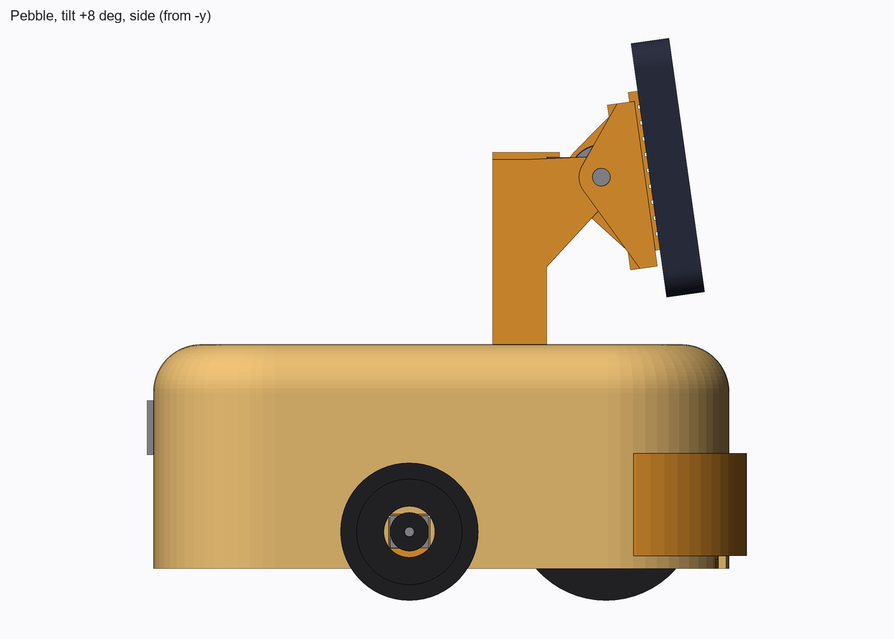
cad/renders/assembly_side_rest.png
