Heinvdm/pebble/cad/renders/assembly_side_up90.png

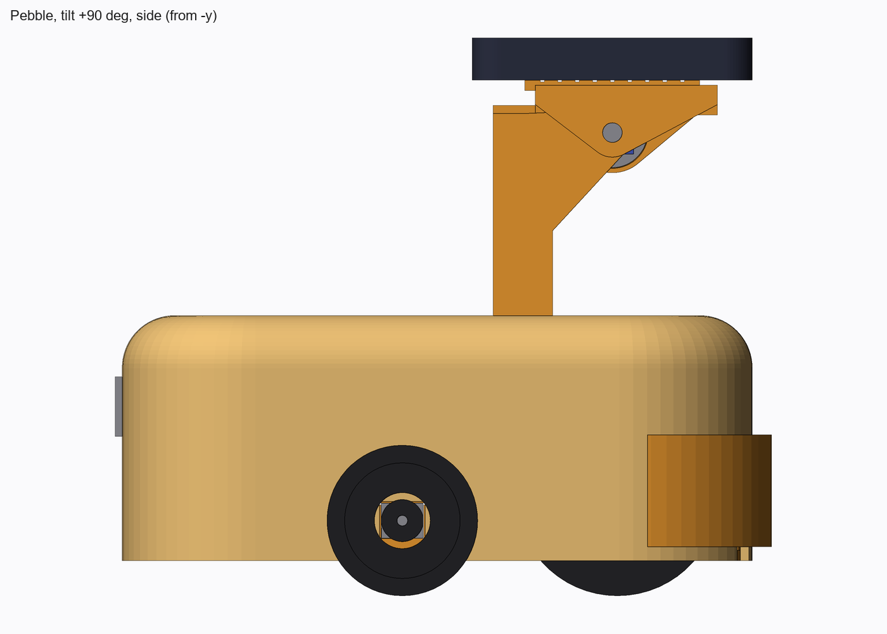
cad/renders/assembly_side_up90.png
