Heinvdm/pebble/brain/tests/data/mouths/chew/00.jpg

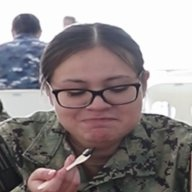
brain/tests/data/mouths/chew/00.jpg
