Heinvdm/pebble/brain/tests/data/mouths/chew/01.jpg

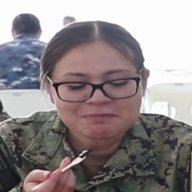
brain/tests/data/mouths/chew/01.jpg
