Heinvdm/pebble/brain/tests/data/mouths/chew/02.jpg

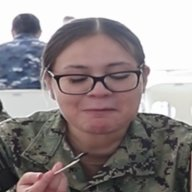
brain/tests/data/mouths/chew/02.jpg
