Heinvdm/pebble/brain/tests/data/mouths/chew/04.jpg

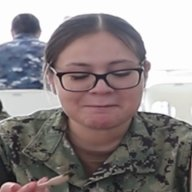
brain/tests/data/mouths/chew/04.jpg
