Heinvdm/pebble/brain/tests/data/mouths/talk/00.jpg

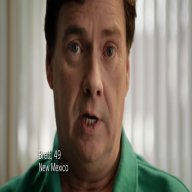
brain/tests/data/mouths/talk/00.jpg
