Heinvdm/pebble/brain/tests/data/teapots/painted_back.jpg

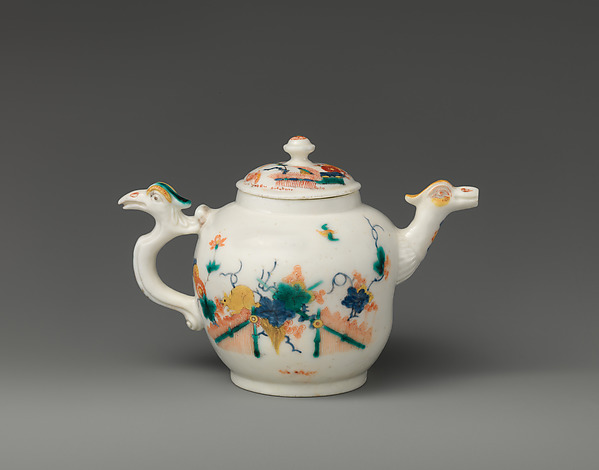
brain/tests/data/teapots/painted_back.jpg
