Heinvdm/pebble/brain/tests/data/teapots/painted_front.jpg

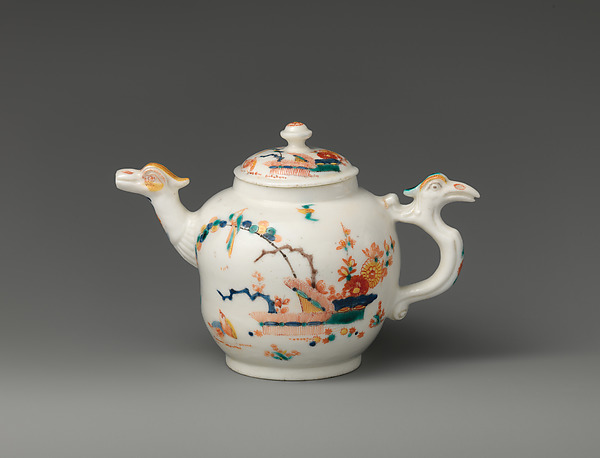
brain/tests/data/teapots/painted_front.jpg
