Heinvdm/pebble/brain/tests/data/teapots/pewter.jpg

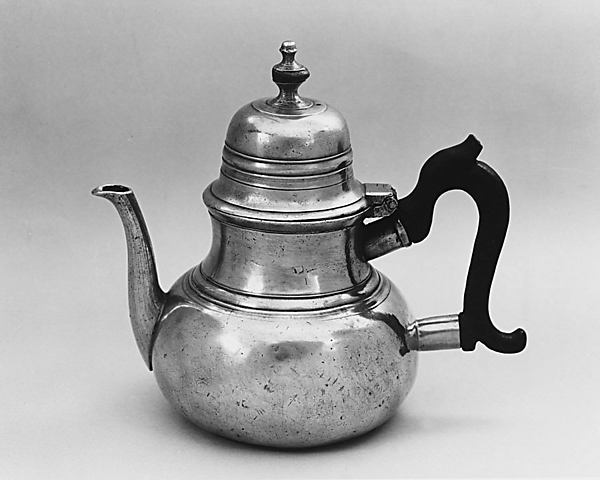
brain/tests/data/teapots/pewter.jpg
