Heinvdm/pebble/brain/tests/data/teapots/white.jpg

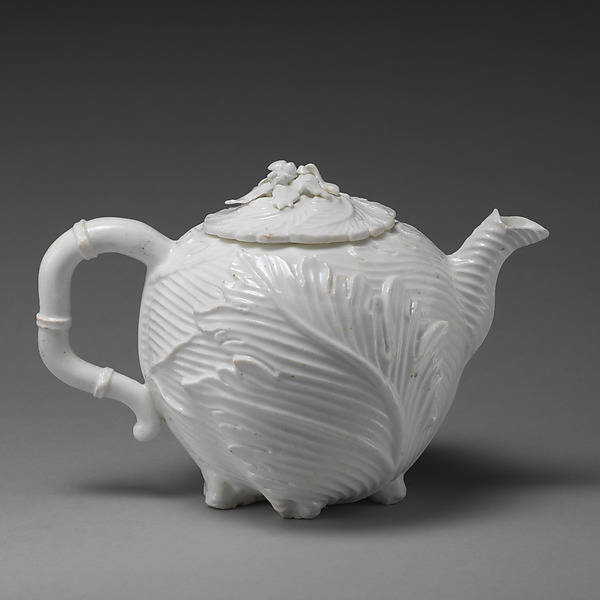
brain/tests/data/teapots/white.jpg
