Heinvdm/pebble/brain/tests/data/hazards/candle_flames.jpg

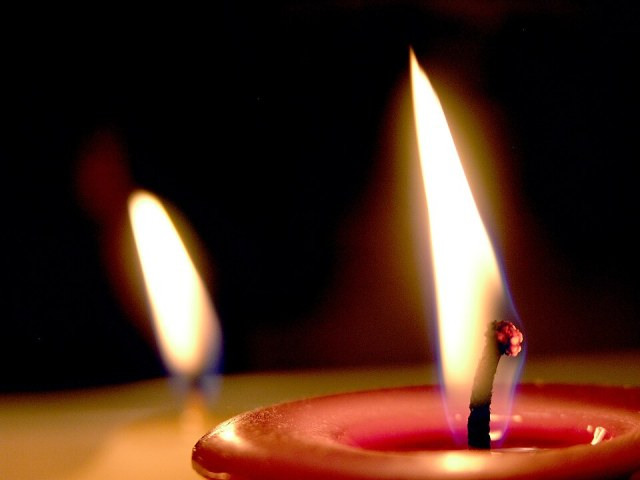
brain/tests/data/hazards/candle_flames.jpg
