Heinvdm/pebble/brain/tests/data/hazards/candle_one.jpg

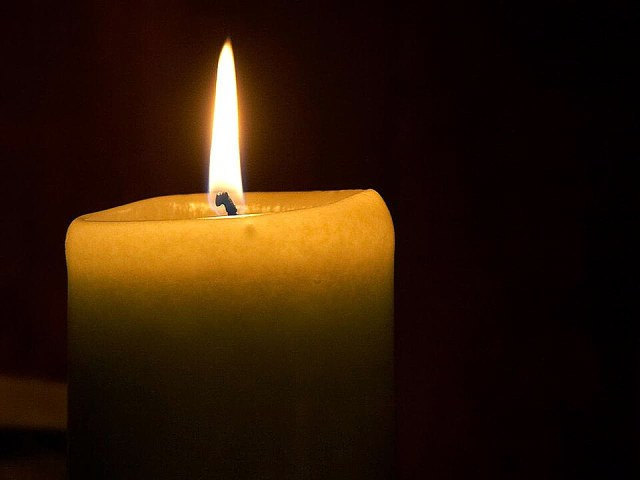
brain/tests/data/hazards/candle_one.jpg
