Heinvdm/pebble/brain/tests/data/hazards/fire_campfire.jpg

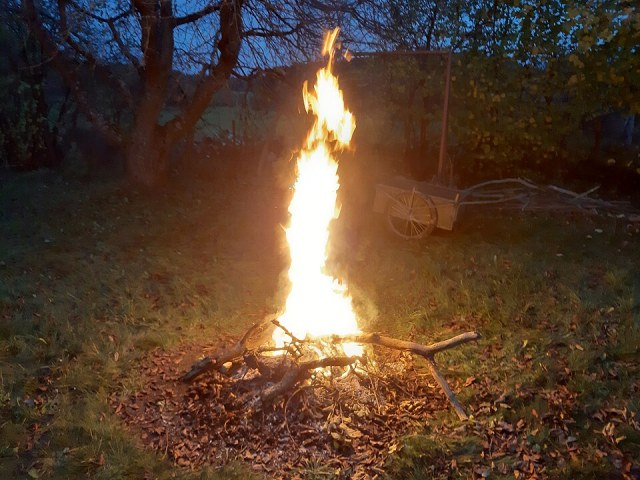
brain/tests/data/hazards/fire_campfire.jpg
