Heinvdm/pebble/brain/tests/data/hazards/fire_chip_pan_2.jpg

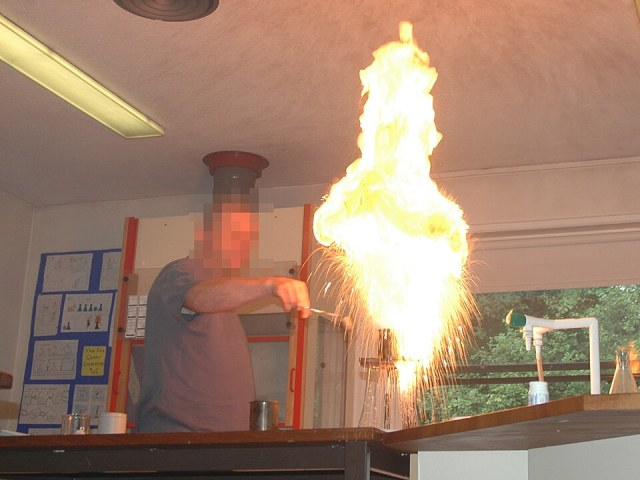
brain/tests/data/hazards/fire_chip_pan_2.jpg
