Heinvdm/pebble/brain/tests/data/hazards/fire_chip_pan_3.jpg

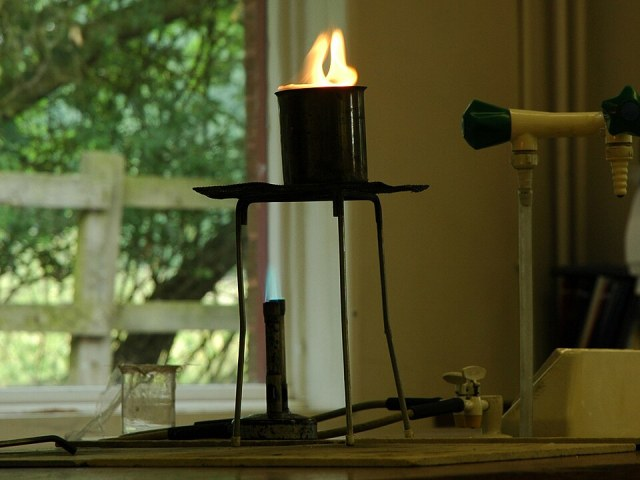
brain/tests/data/hazards/fire_chip_pan_3.jpg
