Heinvdm/pebble/brain/tests/data/hazards/fire_grease.jpg

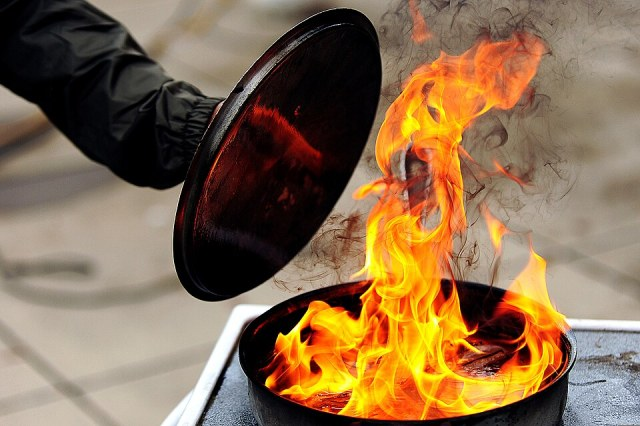
brain/tests/data/hazards/fire_grease.jpg
