Heinvdm/pebble/brain/tests/data/hazards/fire_house.jpg

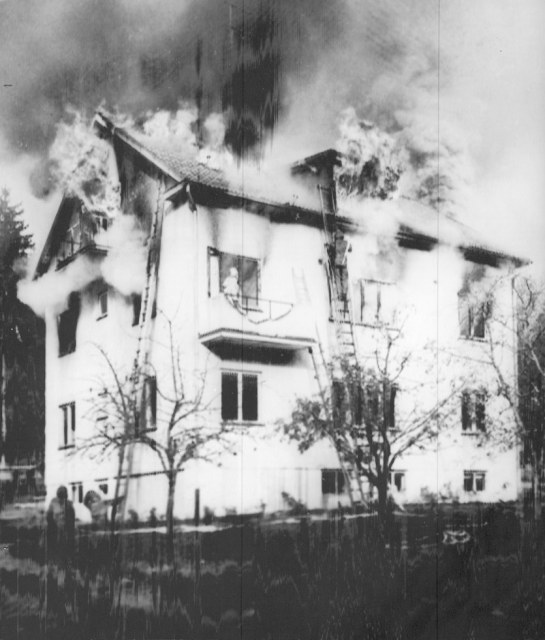
brain/tests/data/hazards/fire_house.jpg
