Heinvdm/pebble/brain/tests/data/hazards/fireplace.jpg

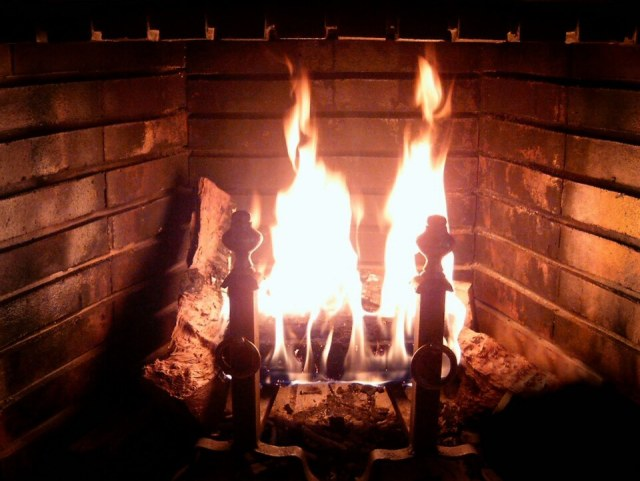
brain/tests/data/hazards/fireplace.jpg
