Heinvdm/pebble/brain/tests/data/hazards/gas_burner.jpg

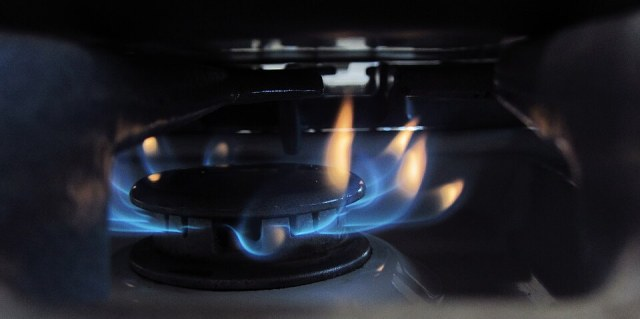
brain/tests/data/hazards/gas_burner.jpg
