Heinvdm/pebble/brain/tests/data/hazards/gas_stove.jpg

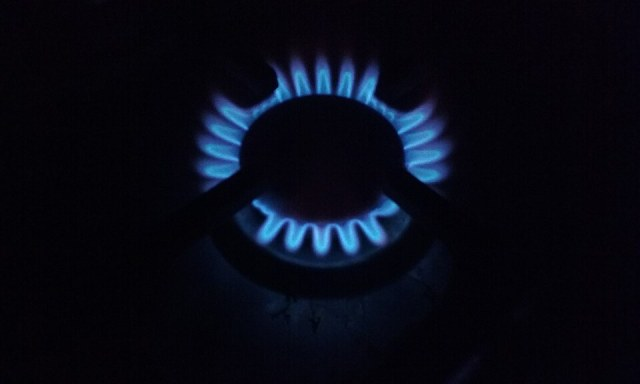
brain/tests/data/hazards/gas_stove.jpg
