Heinvdm/pebble/brain/tests/data/hazards/smoke_fire.jpg

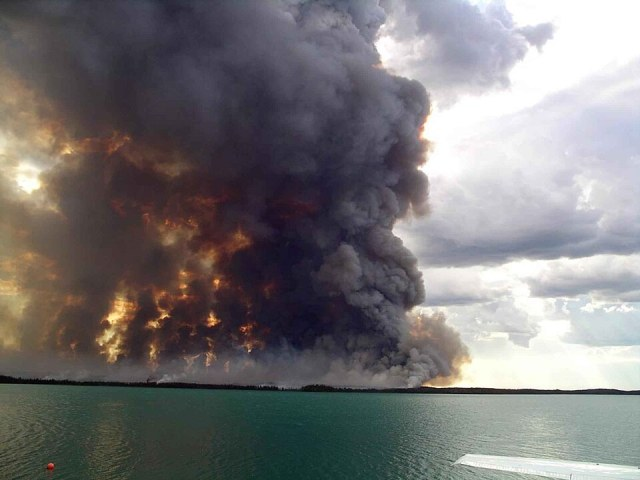
brain/tests/data/hazards/smoke_fire.jpg
