Heinvdm/pebble/brain/tests/data/hazards/smoke_forest.jpg

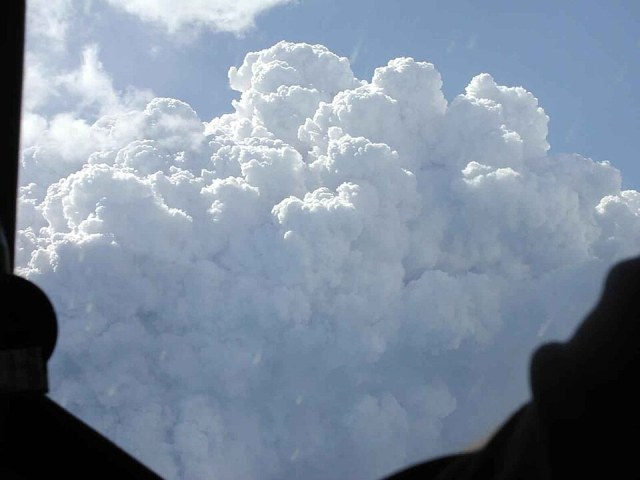
brain/tests/data/hazards/smoke_forest.jpg
