Heinvdm/pebble/brain/tests/data/hazards/steam_kettle.jpg

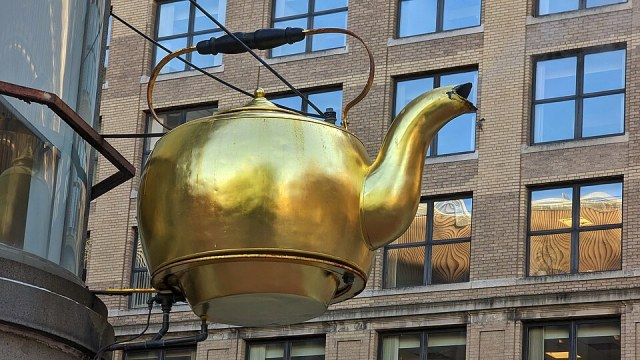
brain/tests/data/hazards/steam_kettle.jpg
