Heinvdm/pebble/brain/tests/data/hazards/sunset_boats.jpg

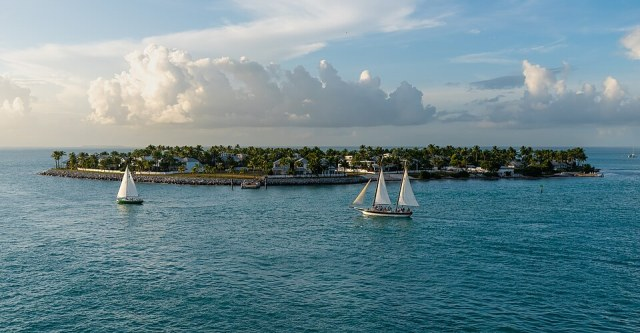
brain/tests/data/hazards/sunset_boats.jpg
