Heinvdm/pebble/brain/tests/data/hazards/sunset_lake.jpg

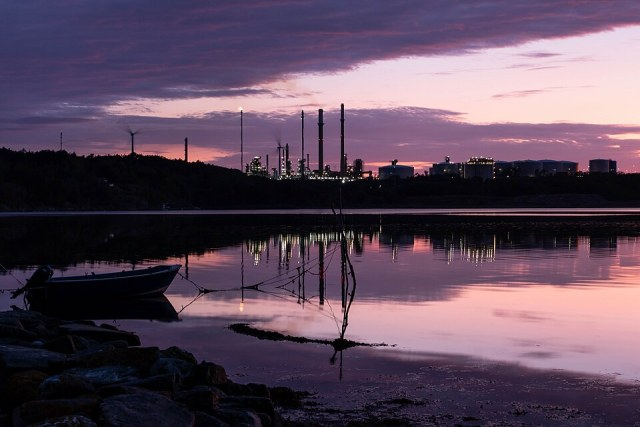
brain/tests/data/hazards/sunset_lake.jpg
