Heinvdm/pebble/brain/tests/data/hazards/tv_room.jpg

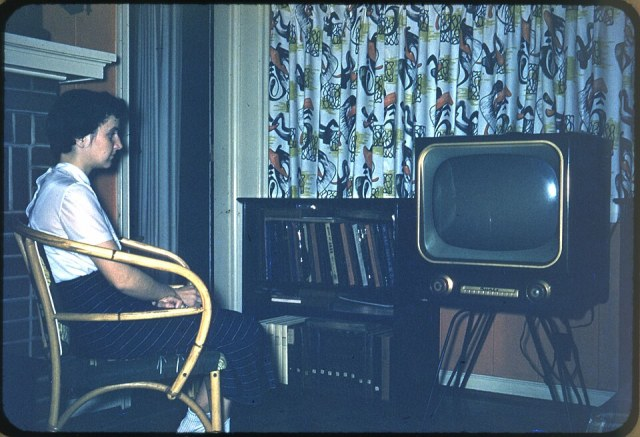
brain/tests/data/hazards/tv_room.jpg
