Heinvdm/pebble/(commit log)

2026-10-23 Pebble: first public version (being tested)
    A phone-brained desk-pet robot: the Python brain, the Android host app,
    the ESP32-S3 firmware, the printable body, plans and research. Tested on
    a PC against the simulator and in an Android emulator only; nothing has
    run on a real phone or body yet.
2026-10-23 Add a humanoid body plan: Poppy on Feetech servos
    New section 8 in plans/new-bodies.md: Poppy Humanoid's printed design
    kept, its Dynamixels swapped for Feetech STS3215 and STS3250 servos,
    the phone as brain and face in the head, a Raspberry Pi on the servo
    bus, and 3S LiPo packs near the centre of mass.
    Claude-Session: https://claude.ai/code/session_019qxDpjBqiV1bAmeDYBjUBw
2026-10-23 Humanoid plan: AliExpress servo prices and what brushless joints would cost
    Section 8 gets the Feetech listings checked on AliExpress (25 servos for about
    NZ$1,050 without GST, against about US$900 in the plan), the sellers looked at
    and set aside, and a parts-by-parts price for home-built and ready-made
    brushless joints: not cheaper overall, only cheaper than the STS3250 hips.
2026-10-23 Humanoid plan: cable and actuator options checked for designability, with every part they need
    Section 8 gets option A (the cable layout: 23 STS3215, spine and hip
    differential on cables, knee and ankle servos moved up the thigh) and option B
    (push-rod knees, a two-rod ankle that adds sideways tilt, twisted-string hands),
    a check that the repo's CAD, MuJoCo and ESP32 tools can carry them, a full parts
    list with AliExpress prices, and the options set aside (switching gearboxes, air
    muscles, memory wire, cheaper direct-drive motors). Also corrects where Poppy's
    four MX-64s are: both hip_y joints and abs_y/abs_x, not four hips. Not designed.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
