Heinvdm/pebble/(notices)

Notices in the files:
brain/README.md:
n `hearing/fetch.py` like the eyes' slow-lane model (`python -m pebble.hearing.fetch --check` checks it; `--samples` fetches the test recordings, all CC0, CC BY 4.0 or public domain, listed with their makers in `fetch.py`).
False alarms, measured:** a real recording of a smoke alarm (CC0, Freesound 369848) is heard for sure 10.5 seconds in, also under talk 12 dB louder than it and through a made-up wall; six other real recordings (another alarm's warble, speech, dogs, glass, a baby, a tap) never matched either pattern.
Words, streaming | NVIDIA NeMo FastConformer streaming transducer, 480 ms chunks, int8 (k2-fsa export) | CC-BY-4.0 | 137 MB
Why these.** Two kinds of clip were used, both licence-clean: LibriSpeech, people reading, CC-BY-4.0; and AMI, real meetings, CC-BY-4.0.
reports/Hexapod motors and boards.md:
**TipTapMotor (MIT licence)** puts an 8:1 three-planet printed planetary on a GBM3506 in a 47 mm cube for about $74 an actuator ([TipTapMotor](https://github.com/DarrenLevine/TipTapMotor)).
**The Waveshare-derived "SCServo" code and Waveshare's ugv_base_general are GPL-3.0, which is copyleft, so keep them out of Pebble** ([scservo](https://raw.githubusercontent.com/workloads/scservo/main/LICENSE); [ugv_base_general](https://raw.githubusercontent.com/waveshareteam/ugv_base_general/main
**Licence flag:** Pebble's firmware uses the Arduino framework, and the **arduino-esp32 core is LGPL-2.1**, a weak copyleft licence ([arduino-esp32 LICENSE](https://github.com/espressif/arduino-esp32/blob/master/LICENSE.md)).
IMU | **Adafruit LSM6DSO32** to prototype; **ICM-45686** on the carrier | 1 each | ±32 g (O) | $12.50 (O) | Adafruit board design CC BY-SA if copied | ICM-42688-P if landings stay under ~12 g; BMI088
- **The Waveshare-derived SCServo code and Waveshare's ugv_base_general are GPL-3.0 (copyleft):** do not use them.
- **The arduino-esp32 core is LGPL-2.1 (weak copyleft):** fine to build on, but changes to the core must stay LGPL.
- **Adafruit and SparkFun board designs are usually CC BY-SA (share-alike)** ([SparkFun repo](https://github.com/sparkfun/LilyPad_Arduino_Simple); [cadlab mirror](https://cadlab.io/project/2057/master/files/misc/Adafruit-VL53L0X-ToF-Distance-Sensor-PCB-master)).
- **Licences not stated or not checked:** CM6, OpenMutt, the cycloidal projects, Tinymovr, MKS ESP32 FOC, Unexpected Maker's design files, the CH224A trigger board, Seeed/Waveshare/LilyGO schematics, and the TDK, ST and Bosch IMU drivers. Treat them as all rights reserved until checked.
